michaelshiloh/motorShieldAndBluefruit/images/bluefruit/2.jpg

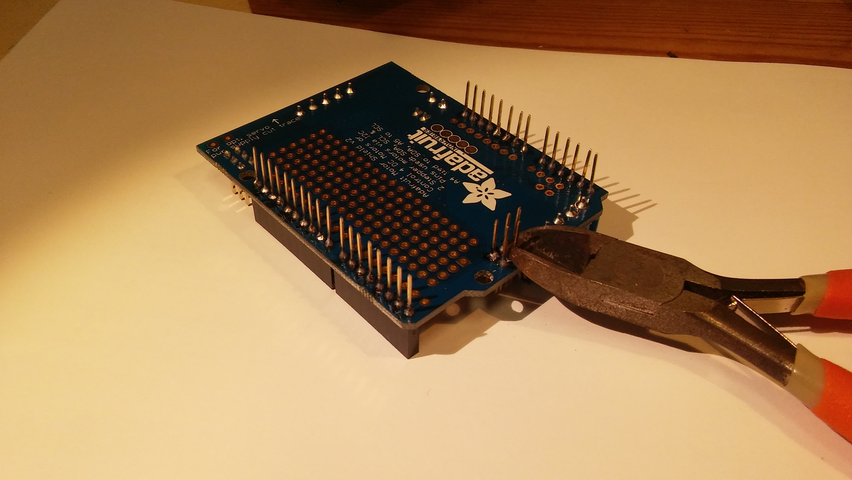
images/bluefruit/2.jpg
