michaelshiloh/motorShieldAndBluefruit/images/bluefruit/3.jpg

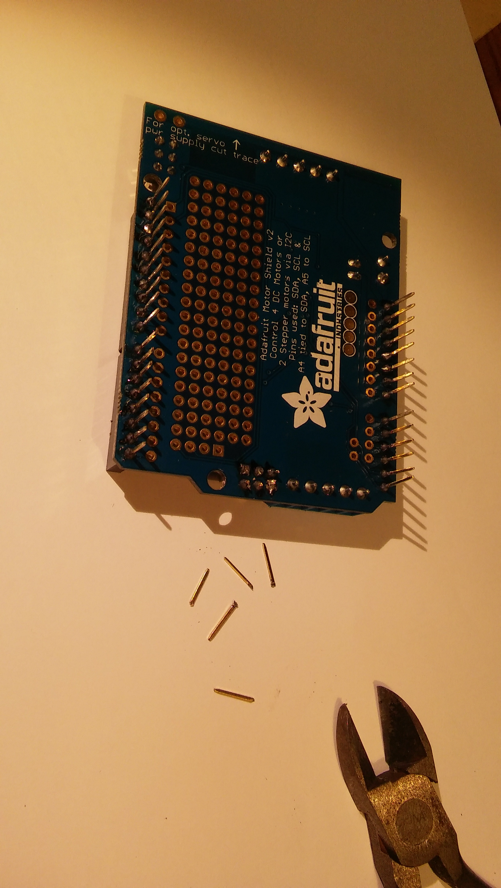
images/bluefruit/3.jpg
