michaelshiloh/motorShieldAndBluefruit/images/bluefruit/4.jpg

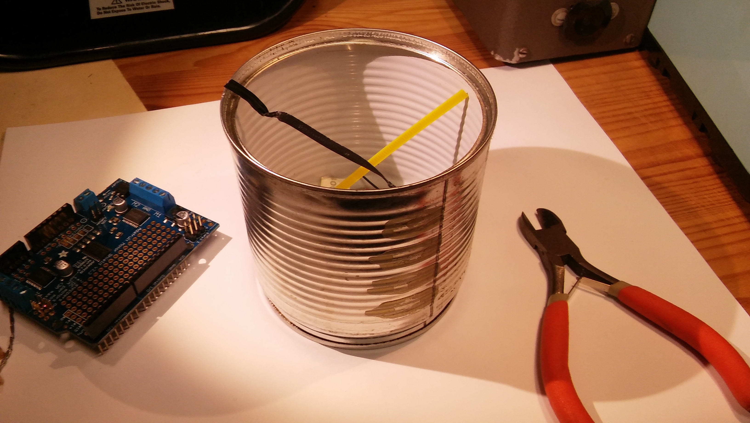
images/bluefruit/4.jpg
