michaelshiloh/motorShieldAndBluefruit/images/bluefruit/5.jpg

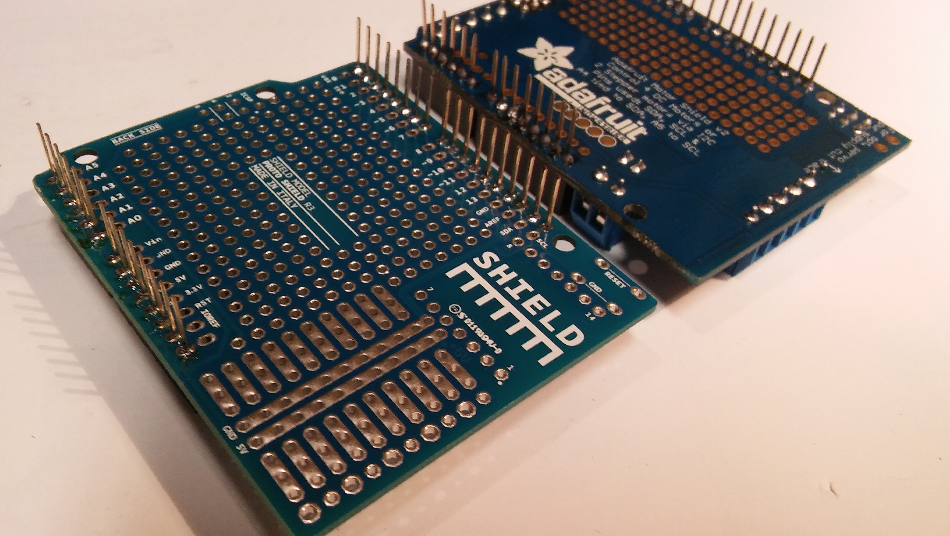
images/bluefruit/5.jpg
