michaelshiloh/motorShieldAndBluefruit/images/bluefruit/6.jpg

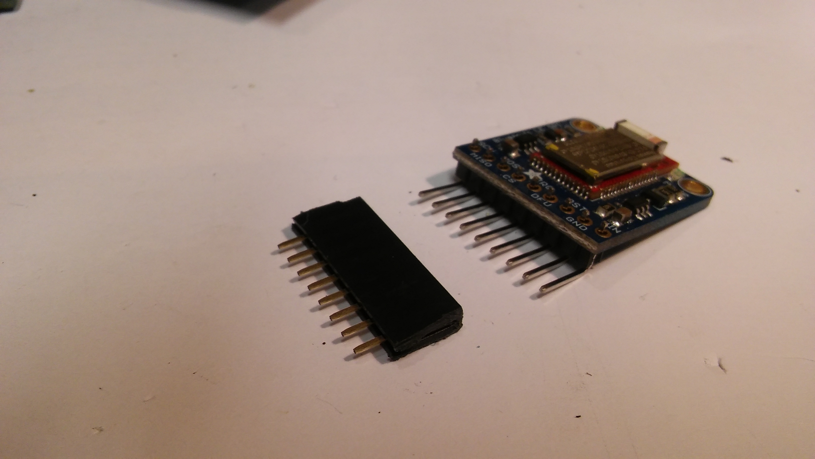
images/bluefruit/6.jpg
