michaelshiloh/motorShieldAndBluefruit/images/bluefruit/7.jpg

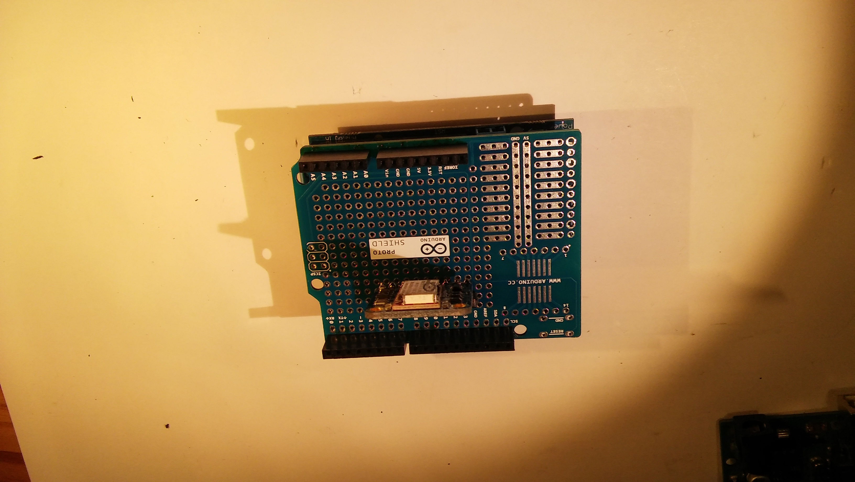
images/bluefruit/7.jpg
