michaelshiloh/motorShieldAndBluefruit/images/bluefruit/8.jpg

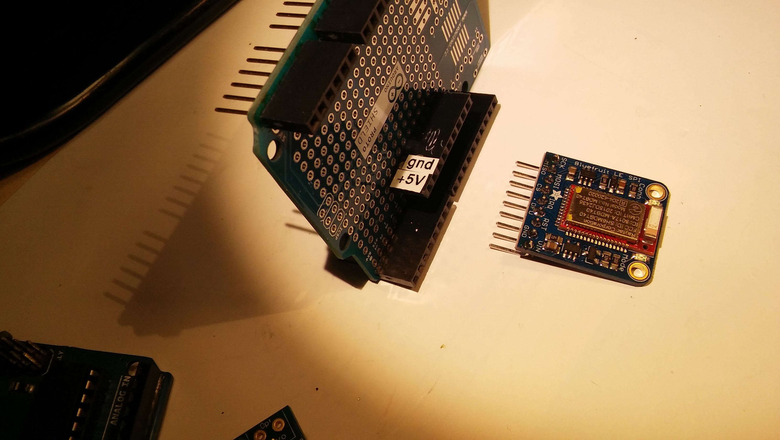
images/bluefruit/8.jpg
