michaelshiloh/motorShieldAndBluefruit/images/bluefruit/9.jpg

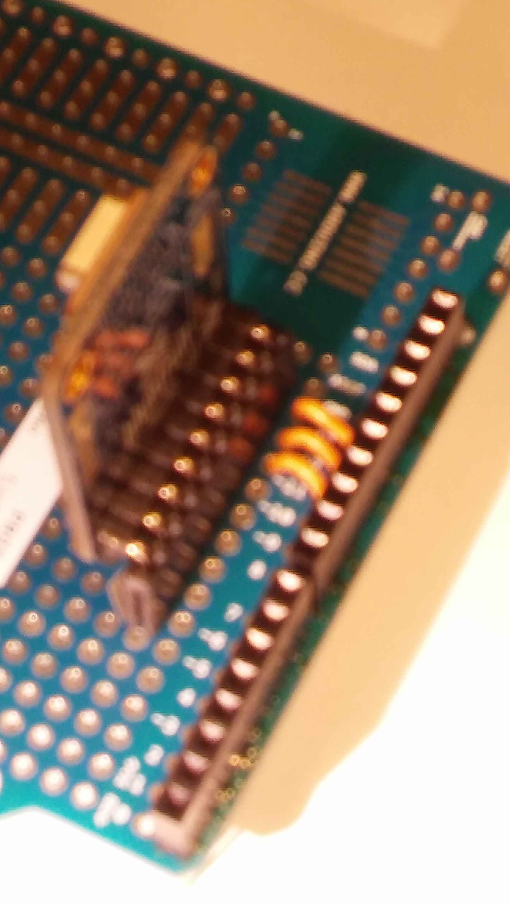
images/bluefruit/9.jpg
