michaelshiloh/motorShieldAndBluefruit/images/bluefruit/10.jpg

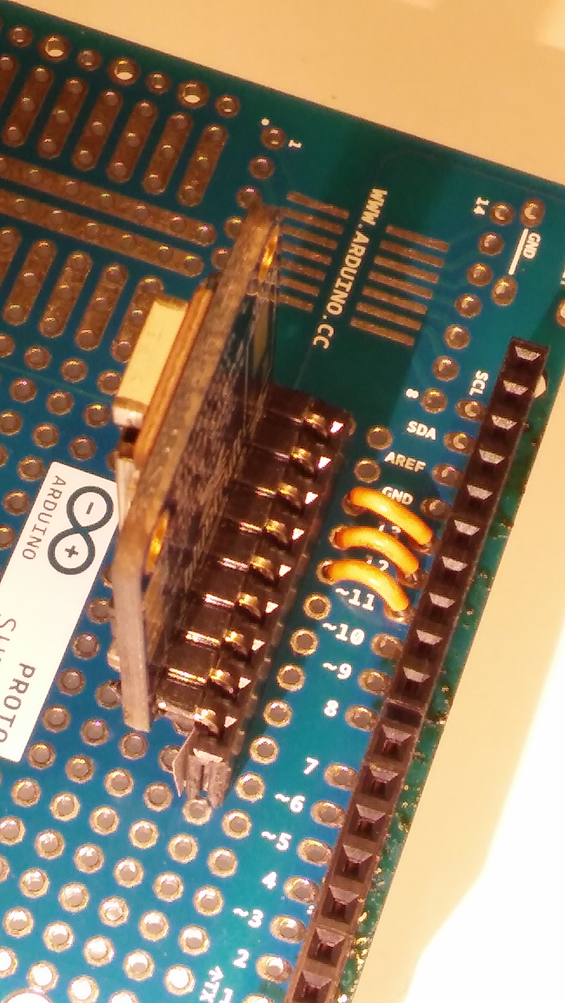
images/bluefruit/10.jpg
