michaelshiloh/motorShieldAndBluefruit/images/bluefruit/11.jpg

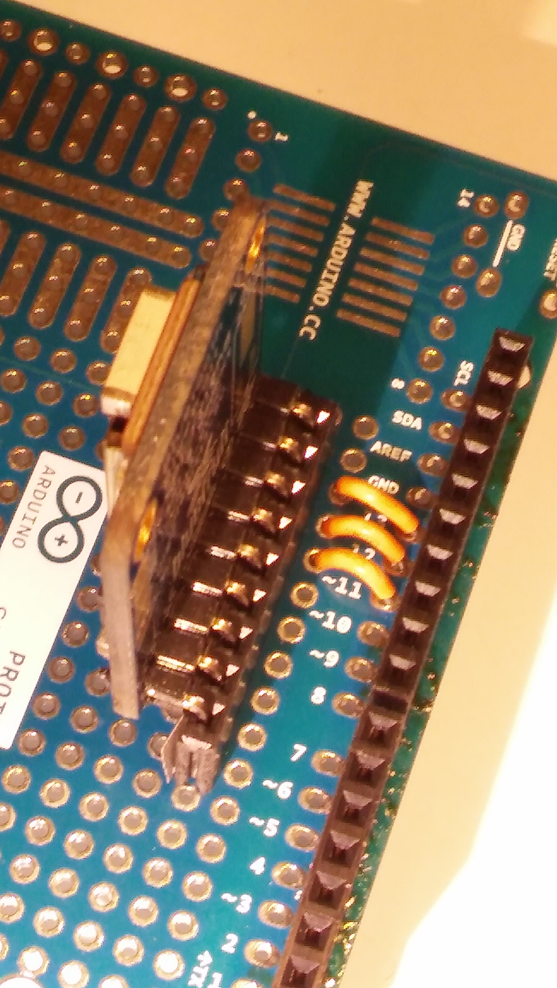
images/bluefruit/11.jpg
