michaelshiloh/motorShieldAndBluefruit/images/bluefruit/12.jpg

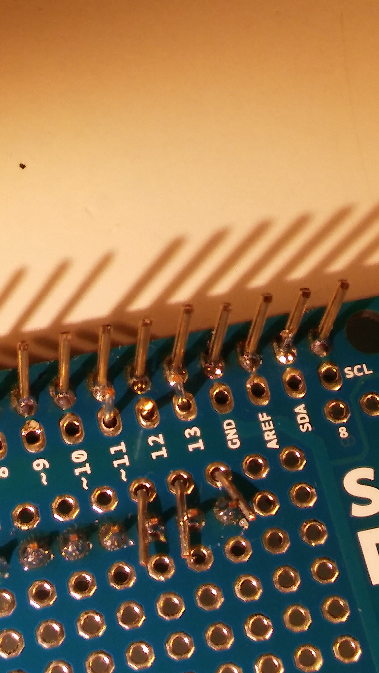
images/bluefruit/12.jpg
