michaelshiloh/motorShieldAndBluefruit/images/bluefruit/13.jpg

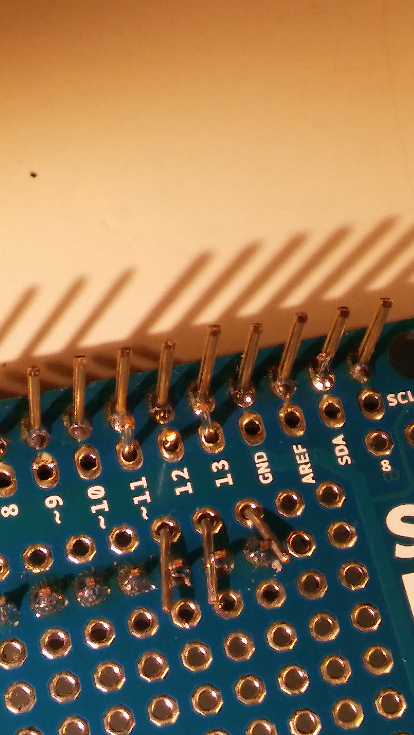
images/bluefruit/13.jpg
