michaelshiloh/motorShieldAndBluefruit/images/bluefruit/14.jpg

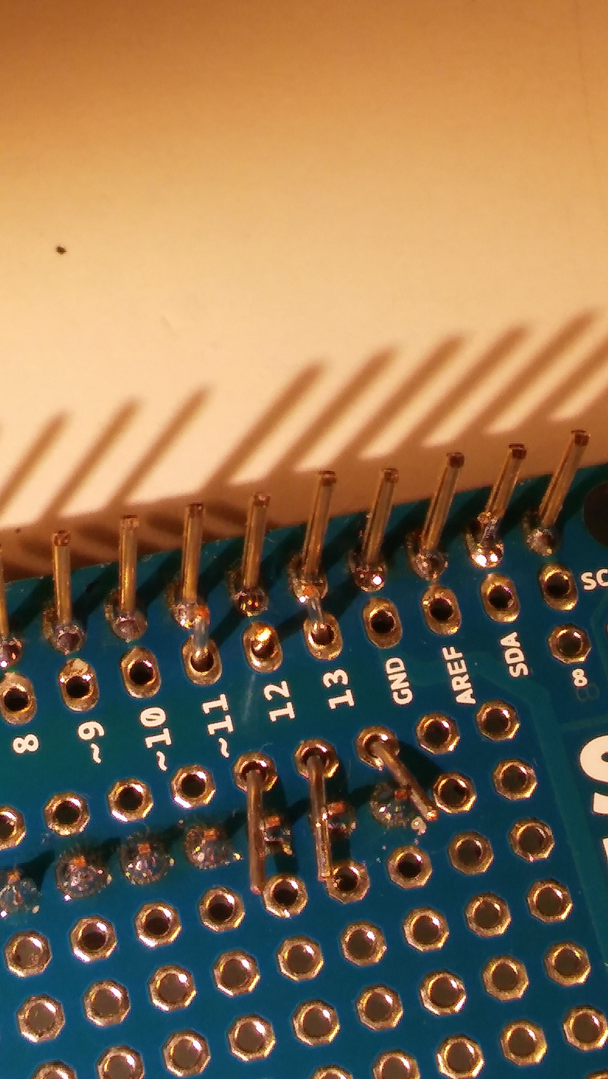
images/bluefruit/14.jpg
