michaelshiloh/motorShieldAndBluefruit/images/bluefruit/15.jpg

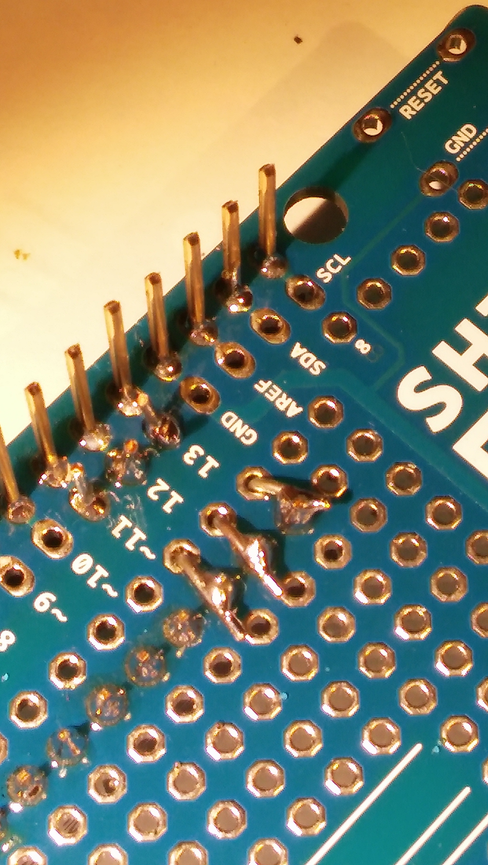
images/bluefruit/15.jpg
