michaelshiloh/motorShieldAndBluefruit/images/bluefruit/16.jpg

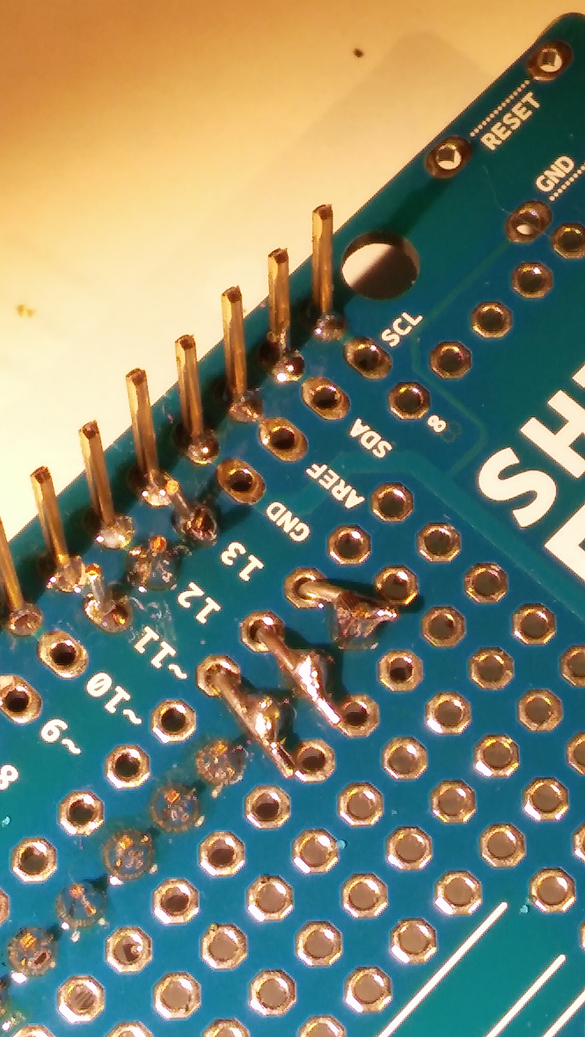
images/bluefruit/16.jpg
