michaelshiloh/motorShieldAndBluefruit/images/bluefruit/18.jpg

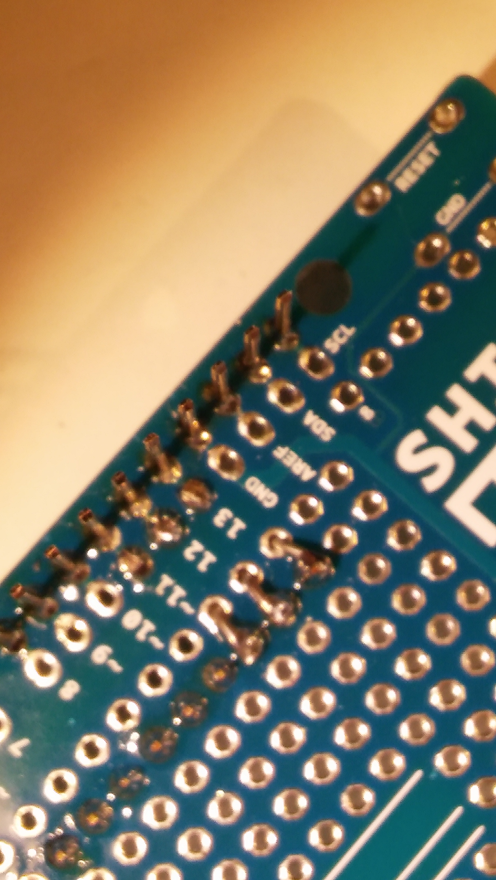
images/bluefruit/18.jpg
