michaelshiloh/motorShieldAndBluefruit/images/bluefruit/19.jpg

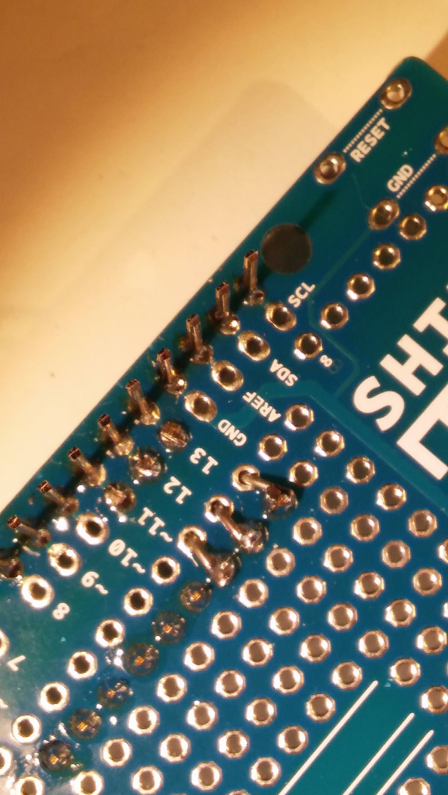
images/bluefruit/19.jpg
