michaelshiloh/motorShieldAndBluefruit/images/bluefruit/24.jpg

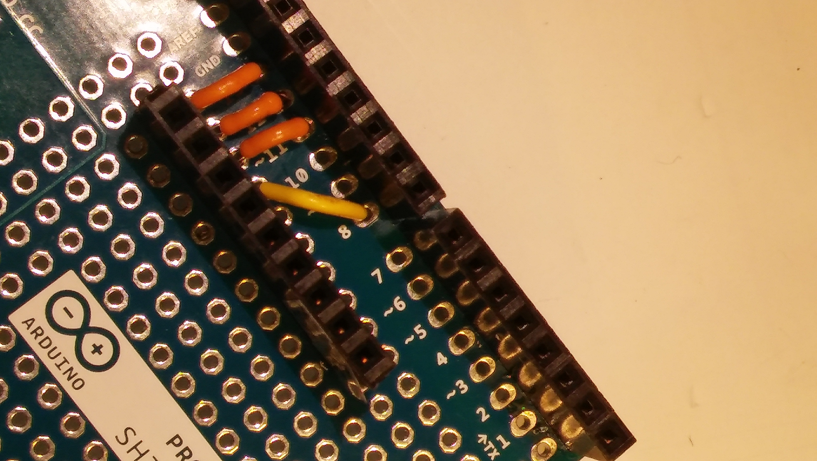
images/bluefruit/24.jpg
