michaelshiloh/motorShieldAndBluefruit/images/bluefruit/25.jpg

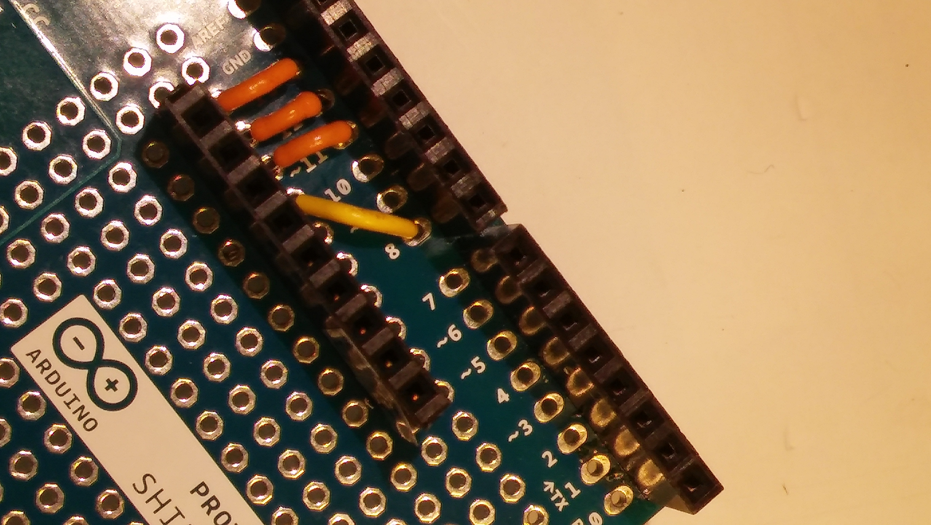
images/bluefruit/25.jpg
