michaelshiloh/motorShieldAndBluefruit/images/bluefruit/27.jpg

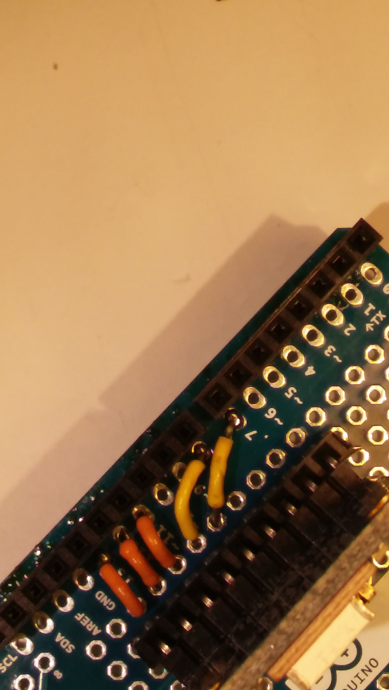
images/bluefruit/27.jpg
