michaelshiloh/motorShieldAndBluefruit/images/bluefruit/29.jpg

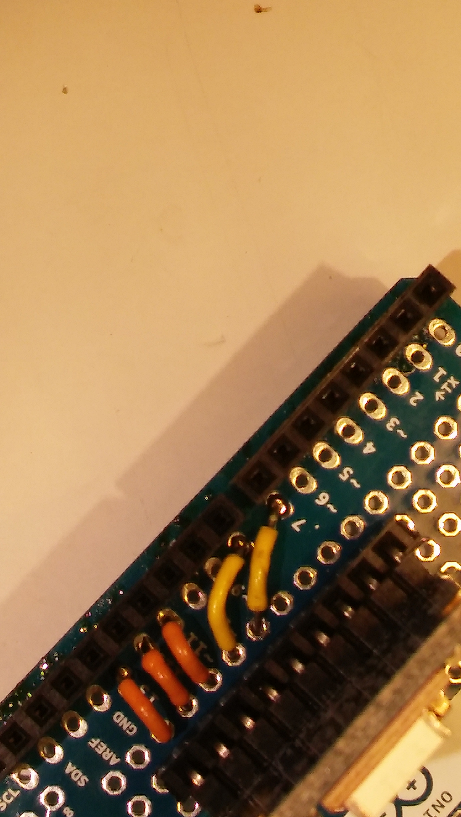
images/bluefruit/29.jpg
