michaelshiloh/motorShieldAndBluefruit/images/bluefruit/30.jpg

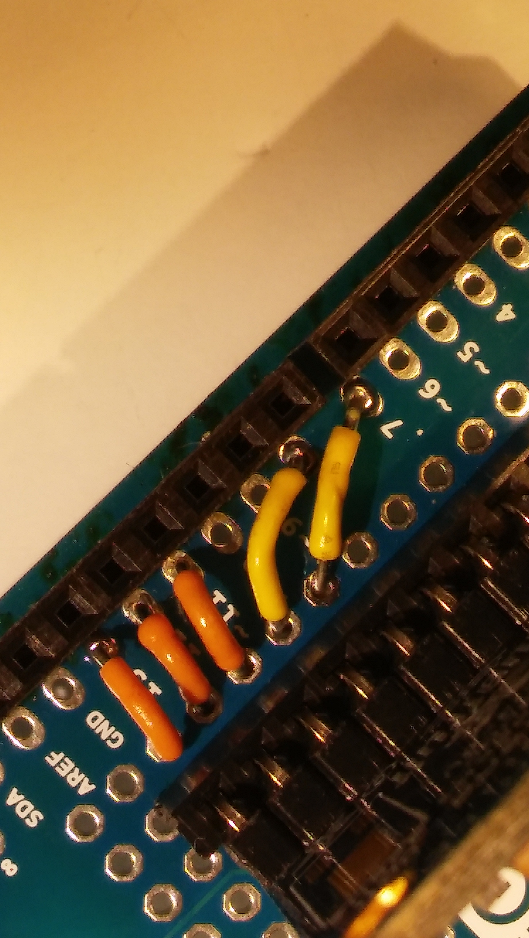
images/bluefruit/30.jpg
