michaelshiloh/motorShieldAndBluefruit/images/bluefruit/31.jpg

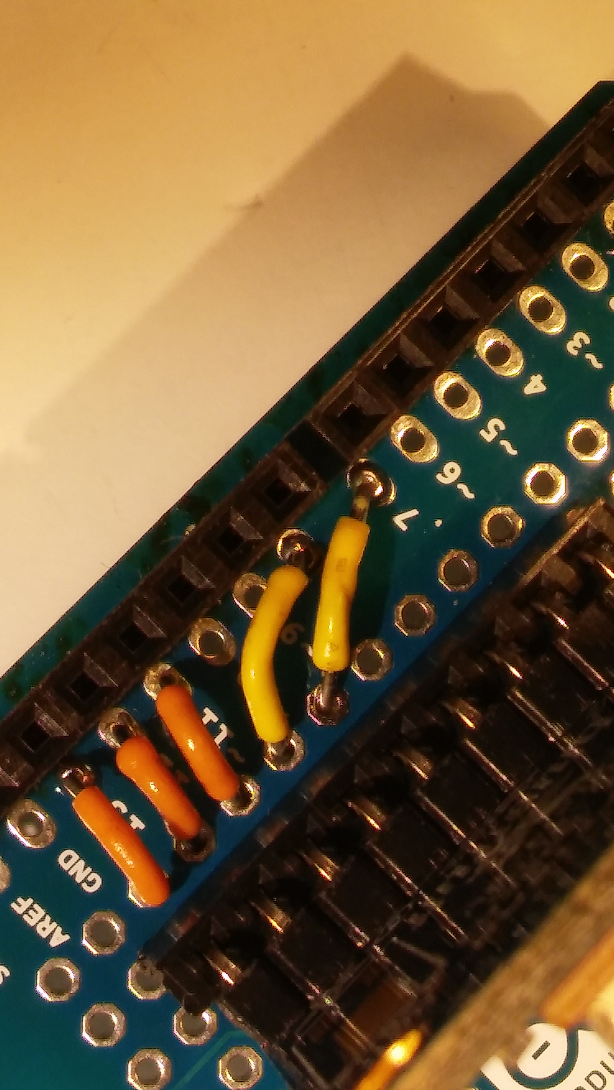
images/bluefruit/31.jpg
