michaelshiloh/motorShieldAndBluefruit/images/bluefruit/32.jpg

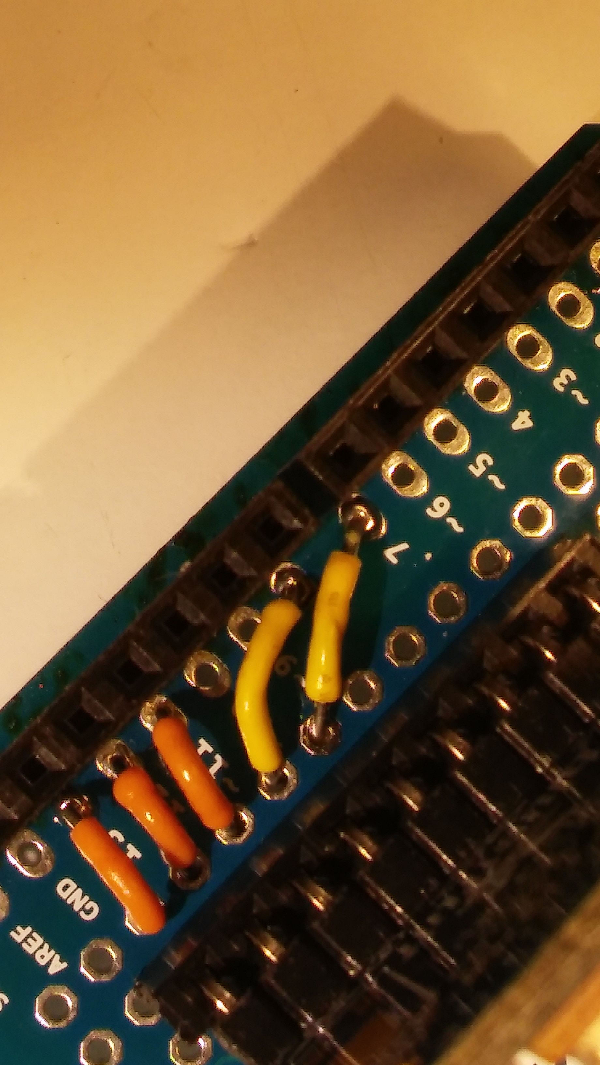
images/bluefruit/32.jpg
