michaelshiloh/motorShieldAndBluefruit/images/bluefruit/33.jpg

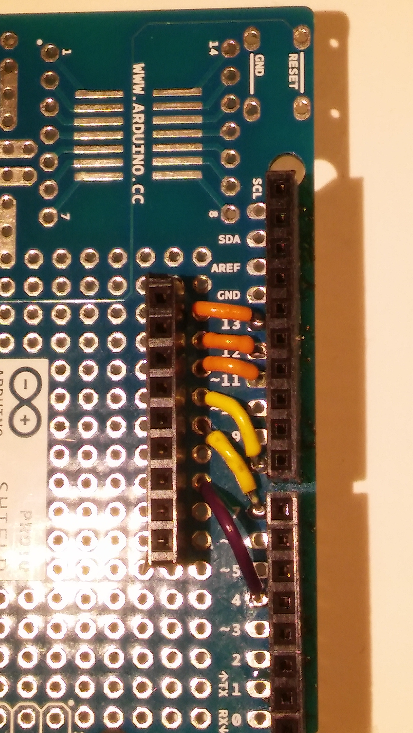
images/bluefruit/33.jpg
