michaelshiloh/motorShieldAndBluefruit/images/bluefruit/34.jpg

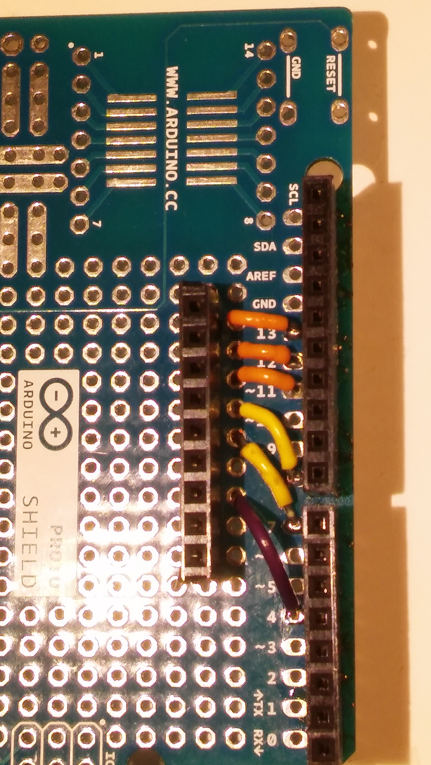
images/bluefruit/34.jpg
