michaelshiloh/motorShieldAndBluefruit/images/bluefruit/35.jpg

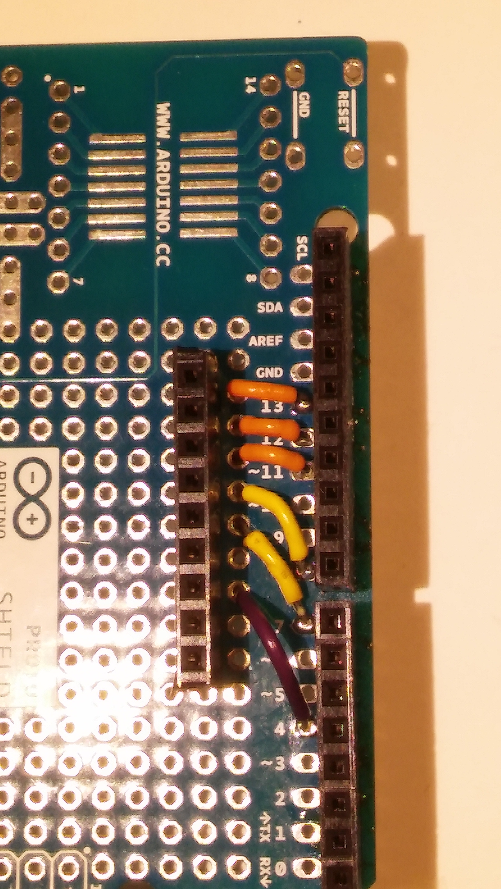
images/bluefruit/35.jpg
