michaelshiloh/motorShieldAndBluefruit/images/bluefruit/36.jpg

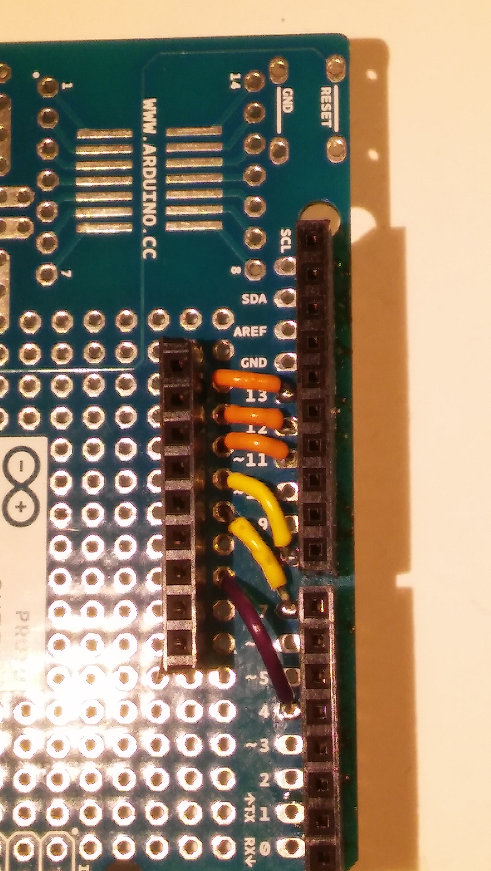
images/bluefruit/36.jpg
