michaelshiloh/motorShieldAndBluefruit/images/bluefruit/37.jpg

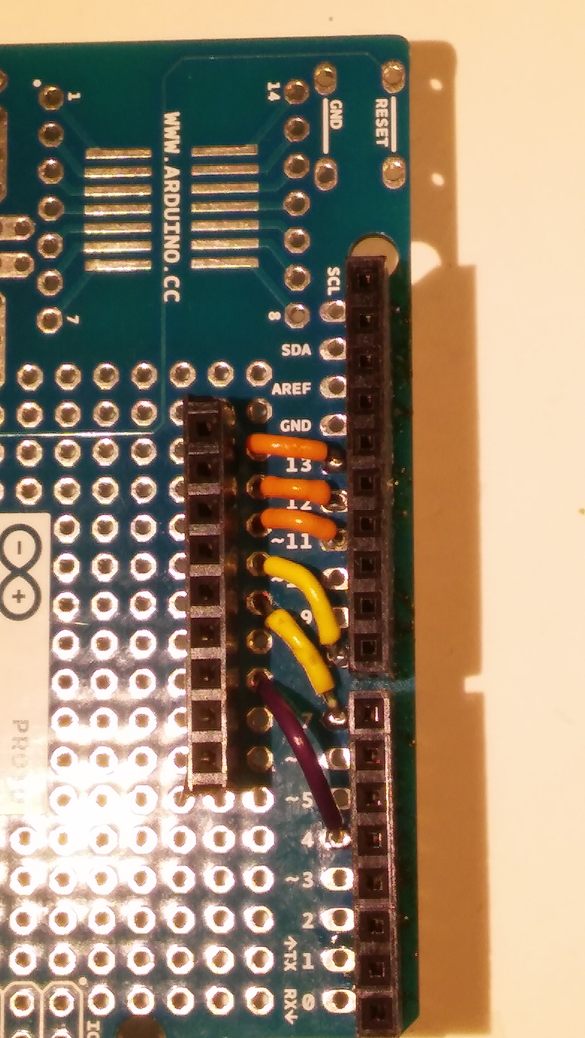
images/bluefruit/37.jpg
