michaelshiloh/motorShieldAndBluefruit/images/bluefruit/39.jpg

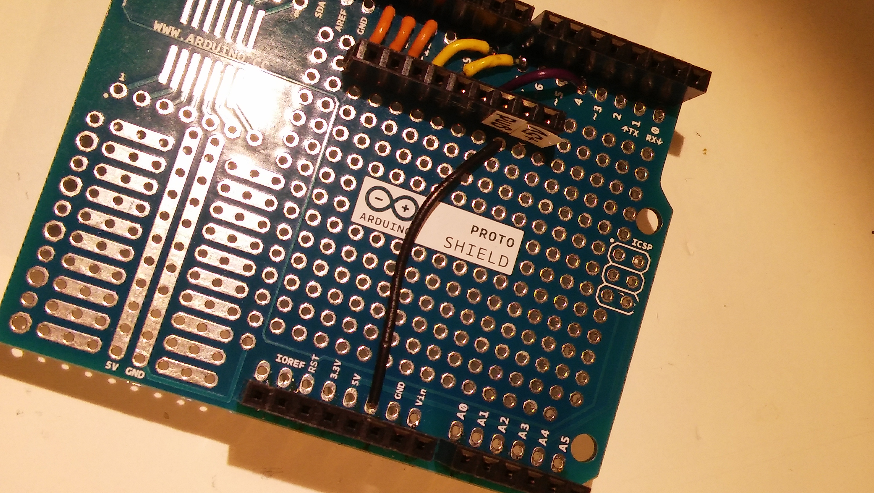
images/bluefruit/39.jpg
