michaelshiloh/motorShieldAndBluefruit/images/bluefruit/41.jpg

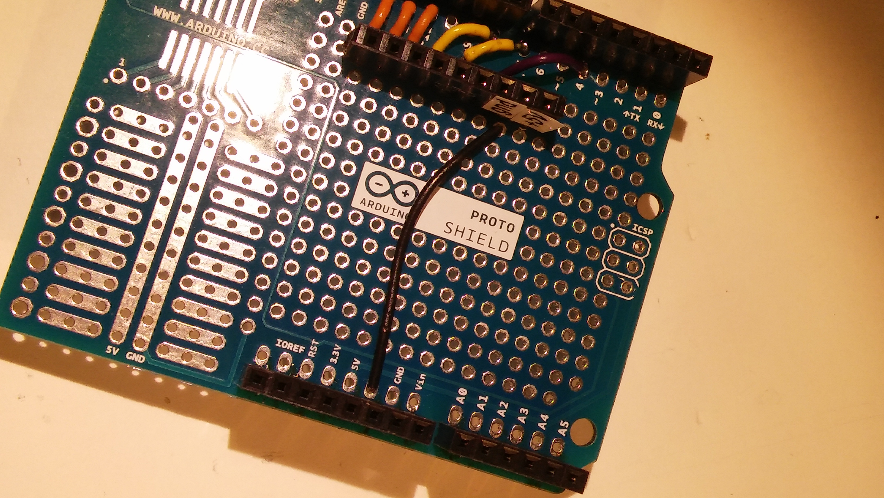
images/bluefruit/41.jpg
