michaelshiloh/motorShieldAndBluefruit/images/bluefruit/42.jpg

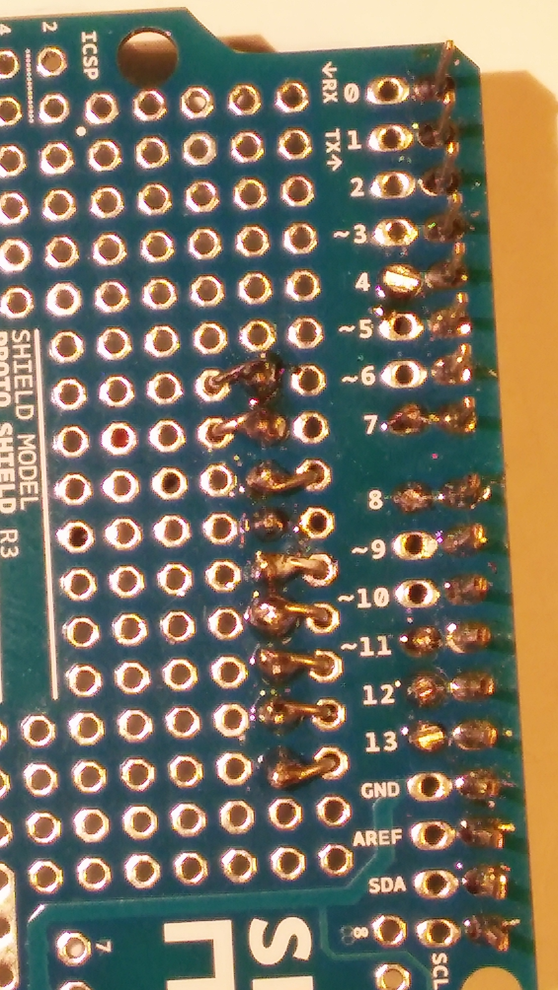
images/bluefruit/42.jpg
