michaelshiloh/motorShieldAndBluefruit/images/bluefruit/43.jpg

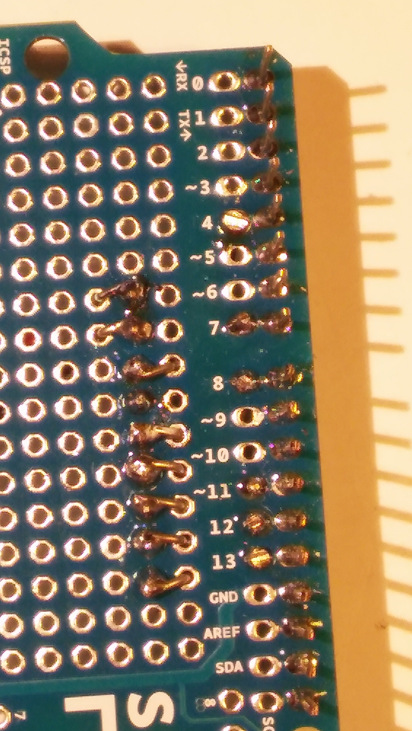
images/bluefruit/43.jpg
