michaelshiloh/motorShieldAndBluefruit/images/bluefruit/44.jpg

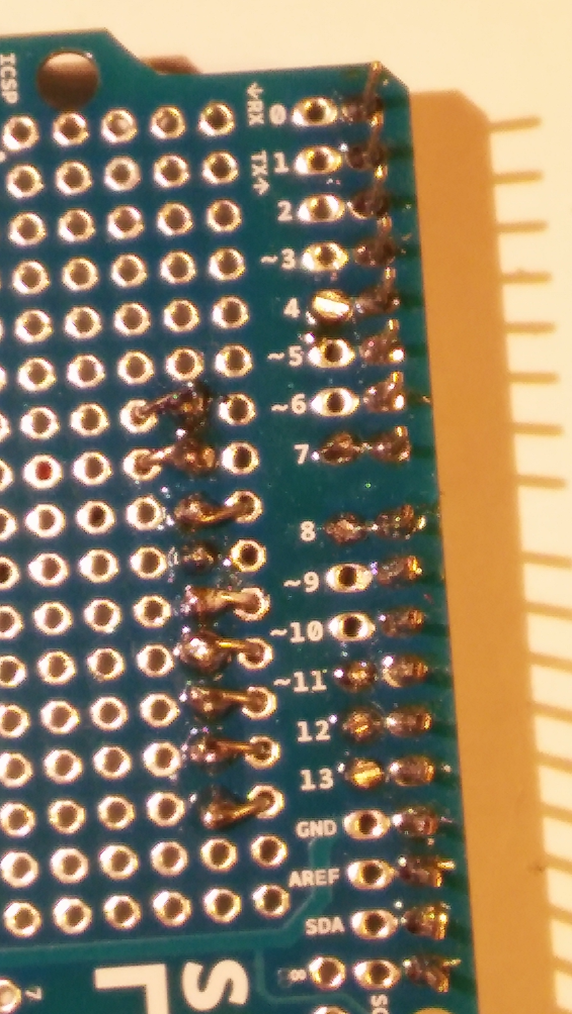
images/bluefruit/44.jpg
