michaelshiloh/motorShieldAndBluefruit/images/bluefruit/45.jpg

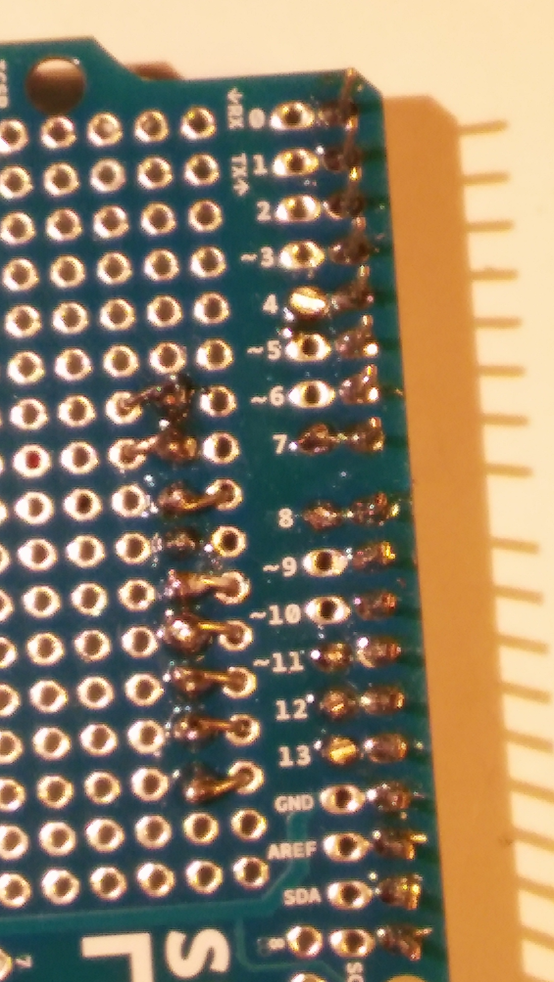
images/bluefruit/45.jpg
