michaelshiloh/motorShieldAndBluefruit/images/bluefruit/46.jpg

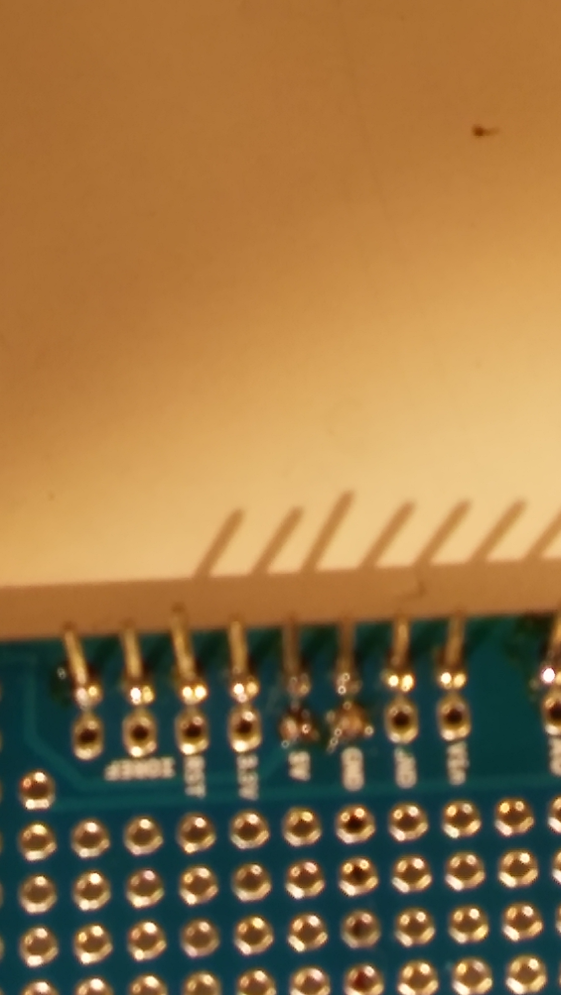
images/bluefruit/46.jpg
