michaelshiloh/motorShieldAndBluefruit/images/bluefruit/47.jpg

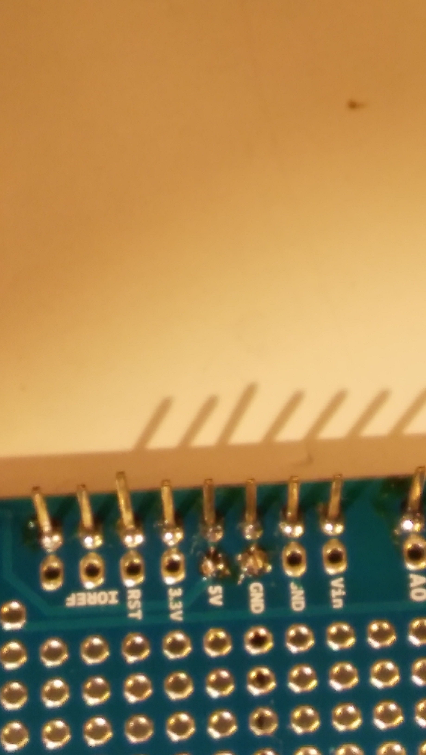
images/bluefruit/47.jpg
