michaelshiloh/motorShieldAndBluefruit/images/bluefruit/48.jpg

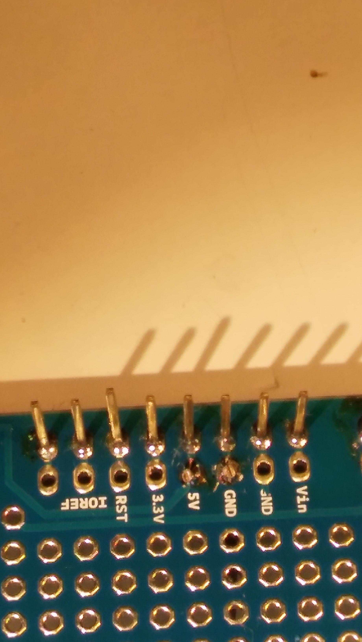
images/bluefruit/48.jpg
