michaelshiloh/motorShieldAndBluefruit/images/bluefruit/49.jpg

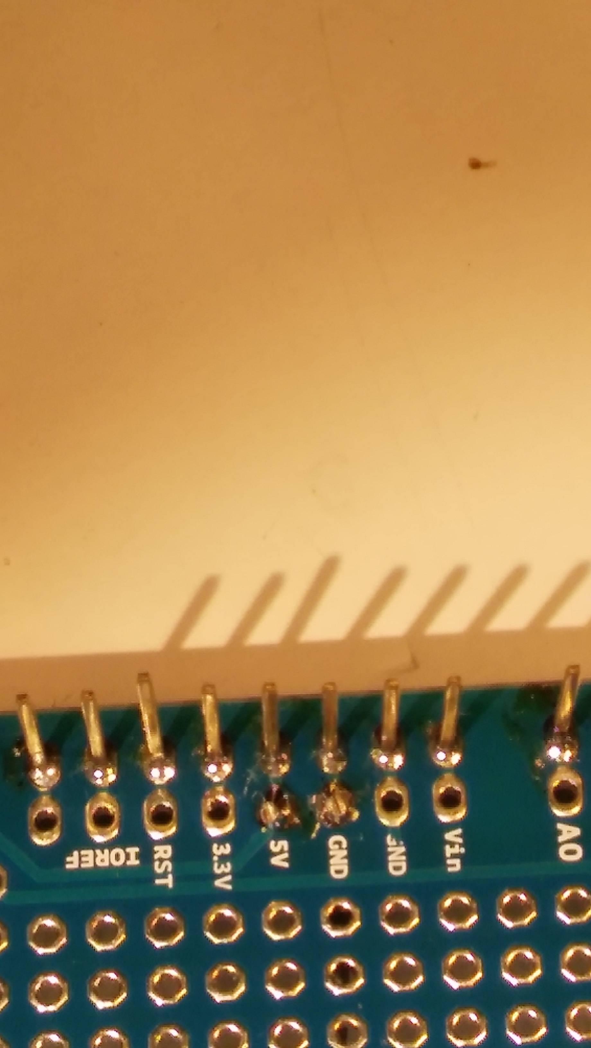
images/bluefruit/49.jpg
