michaelshiloh/motorShieldAndBluefruit/images/bluefruit/50.jpg

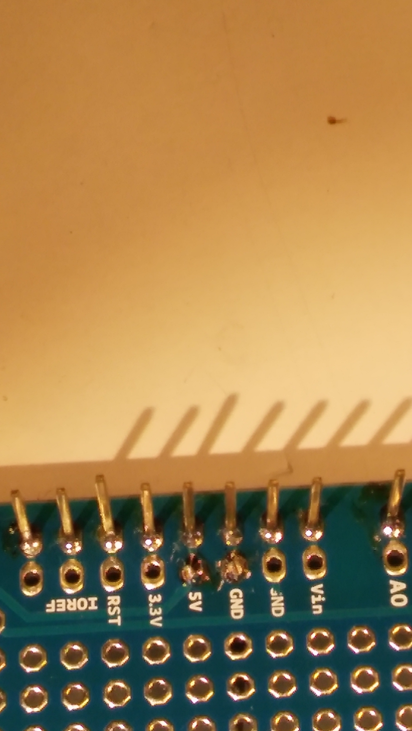
images/bluefruit/50.jpg
