michaelshiloh/motorShieldAndBluefruit/images/bluefruit/60.jpg

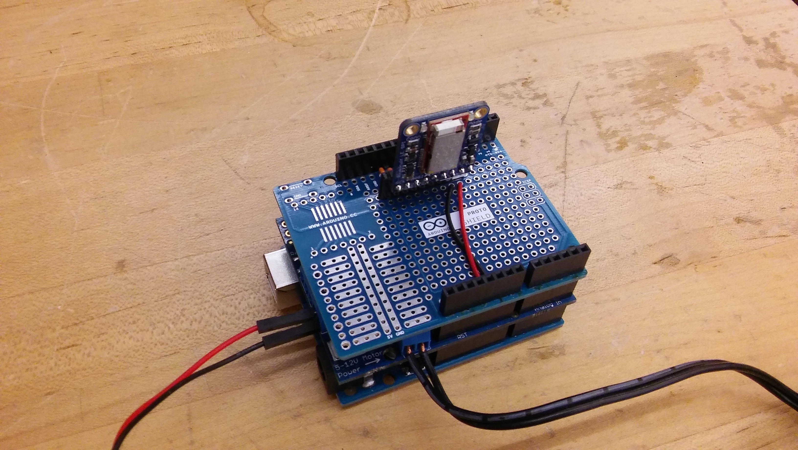
images/bluefruit/60.jpg
