michaelshiloh/motorShieldAndBluefruit/images/bluefruit/61.jpg

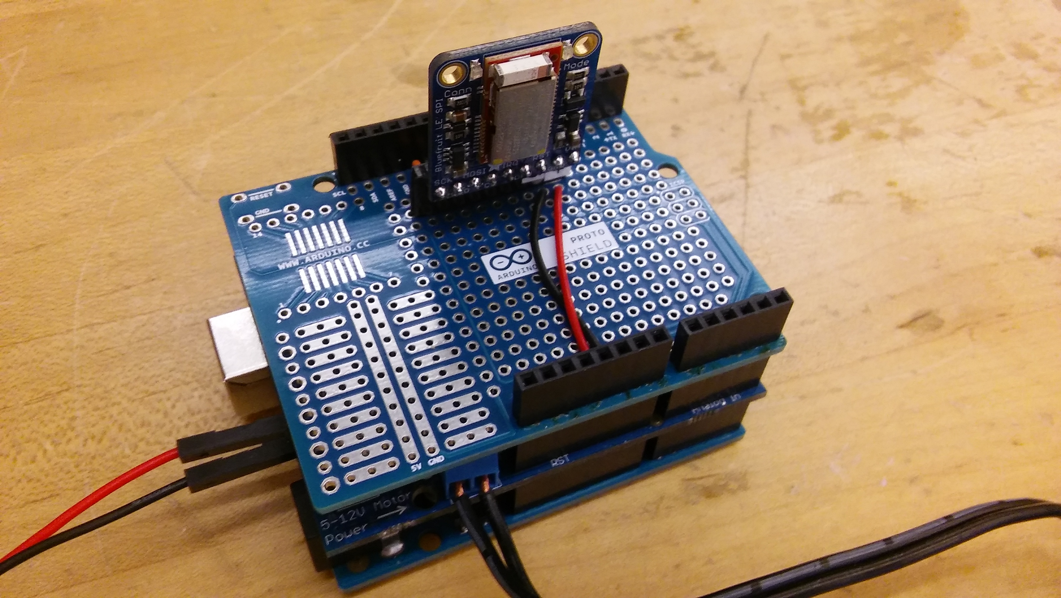
images/bluefruit/61.jpg
