michaelshiloh/motorShieldAndBluefruit/images/bluefruit/62.jpg

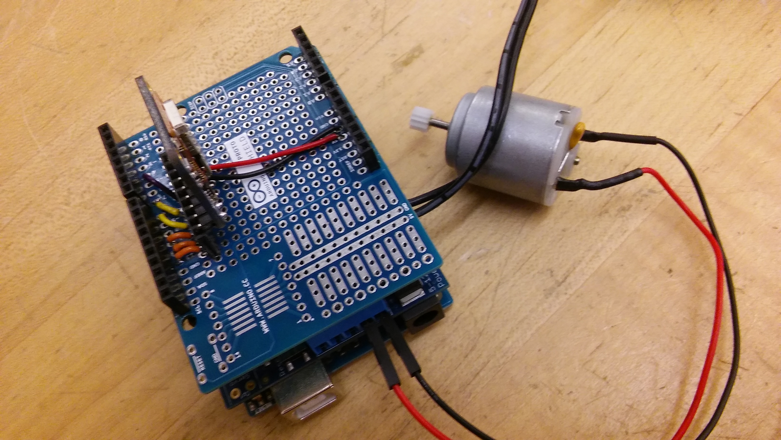
images/bluefruit/62.jpg
