michaelshiloh/motorShieldAndBluefruit/images/bluefruit/63.jpg

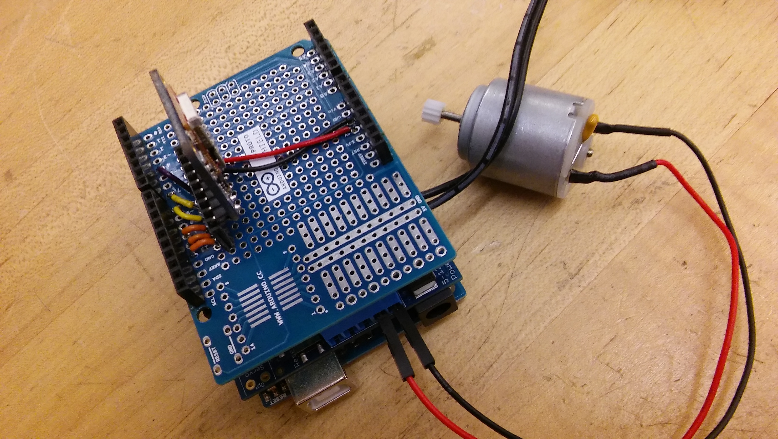
images/bluefruit/63.jpg
