michaelshiloh/motorShieldAndBluefruit/images/bluefruit/64.jpg

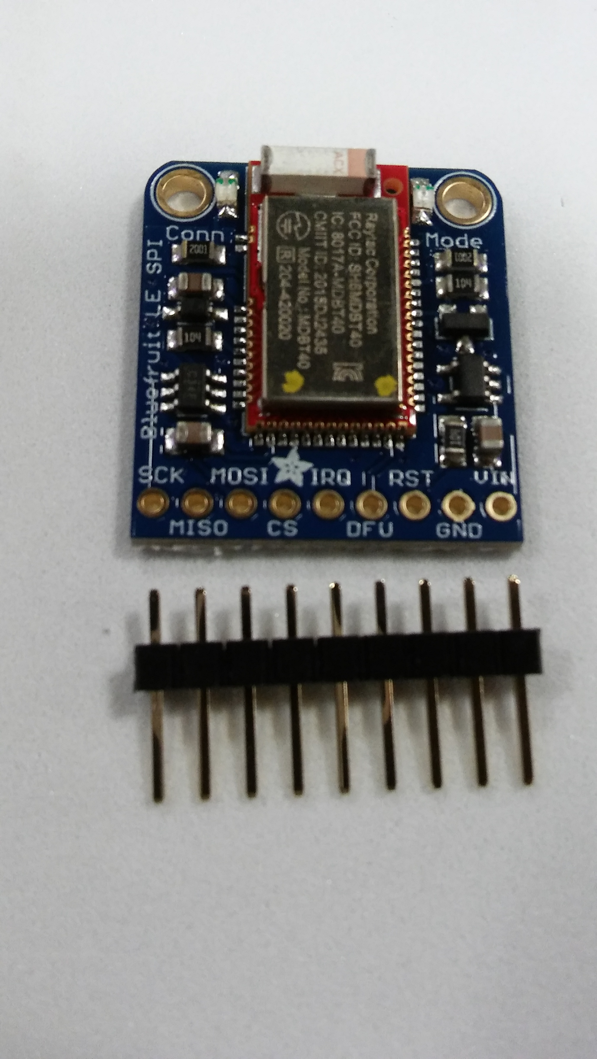
images/bluefruit/64.jpg
