michaelshiloh/motorShieldAndBluefruit/images/bluefruit/65.jpg

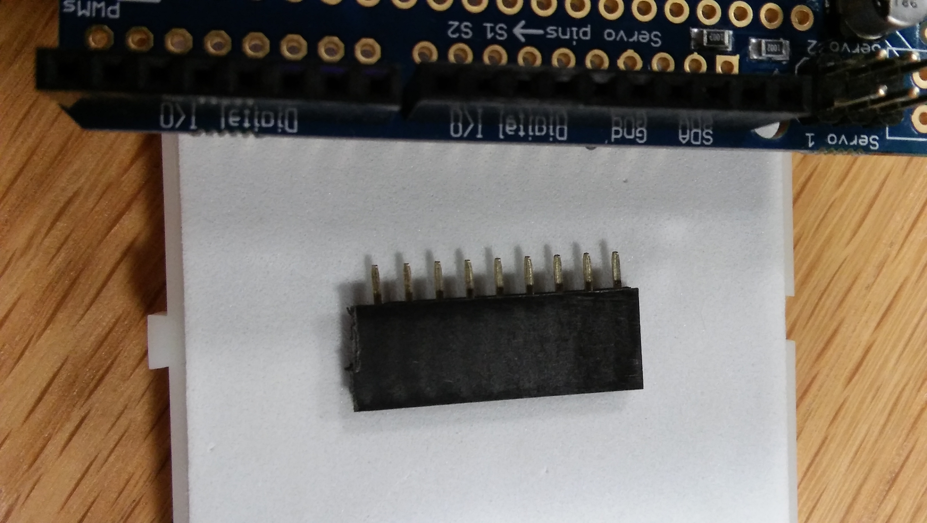
images/bluefruit/65.jpg
