michaelshiloh/motorShieldAndBluefruit/images/bluefruit/67.jpg

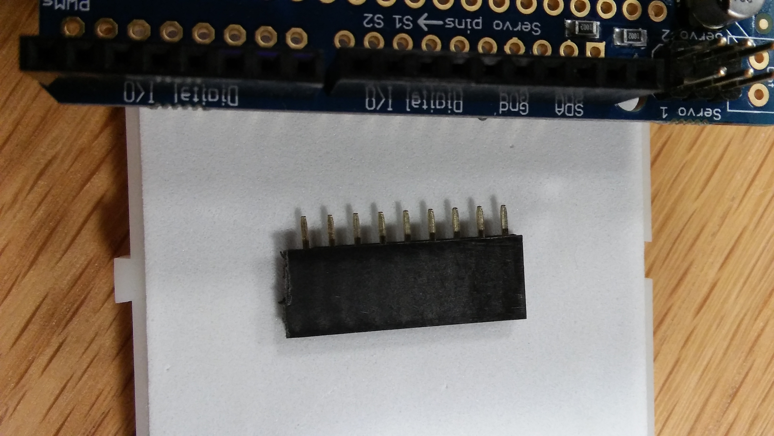
images/bluefruit/67.jpg
