michaelshiloh/motorShieldAndBluefruit/images/bluefruit/68.jpg

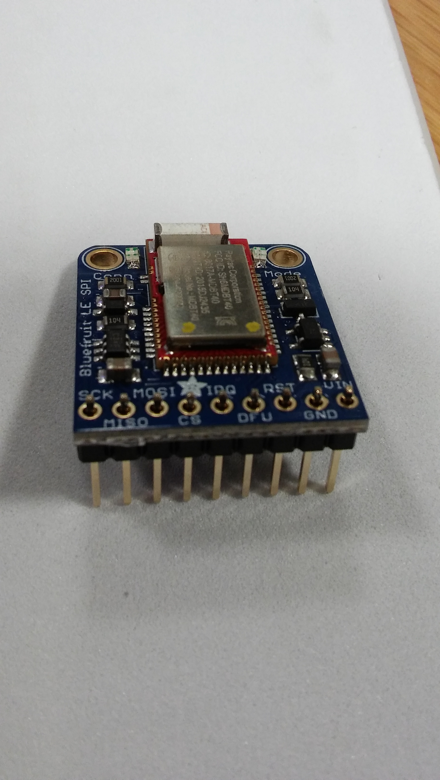
images/bluefruit/68.jpg
