michaelshiloh/motorShieldAndBluefruit/images/bluefruit/69.jpg

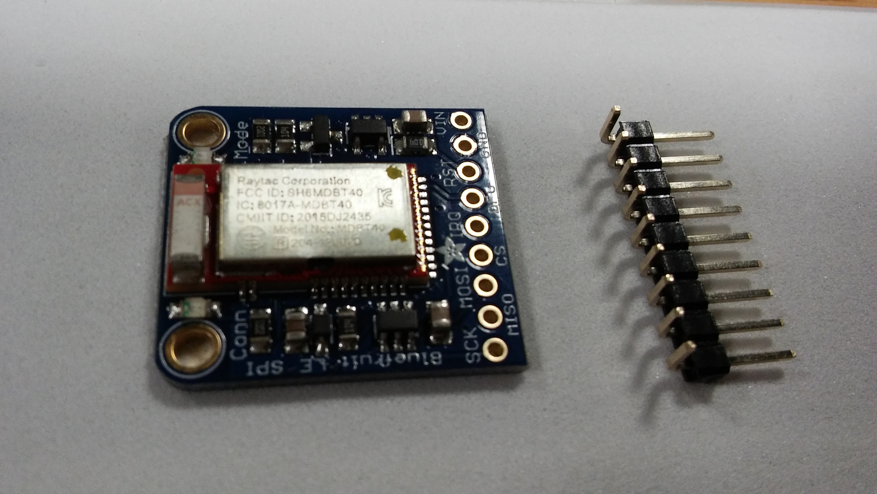
images/bluefruit/69.jpg
