michaelshiloh/motorShieldAndBluefruit/images/bluefruit/70.jpg

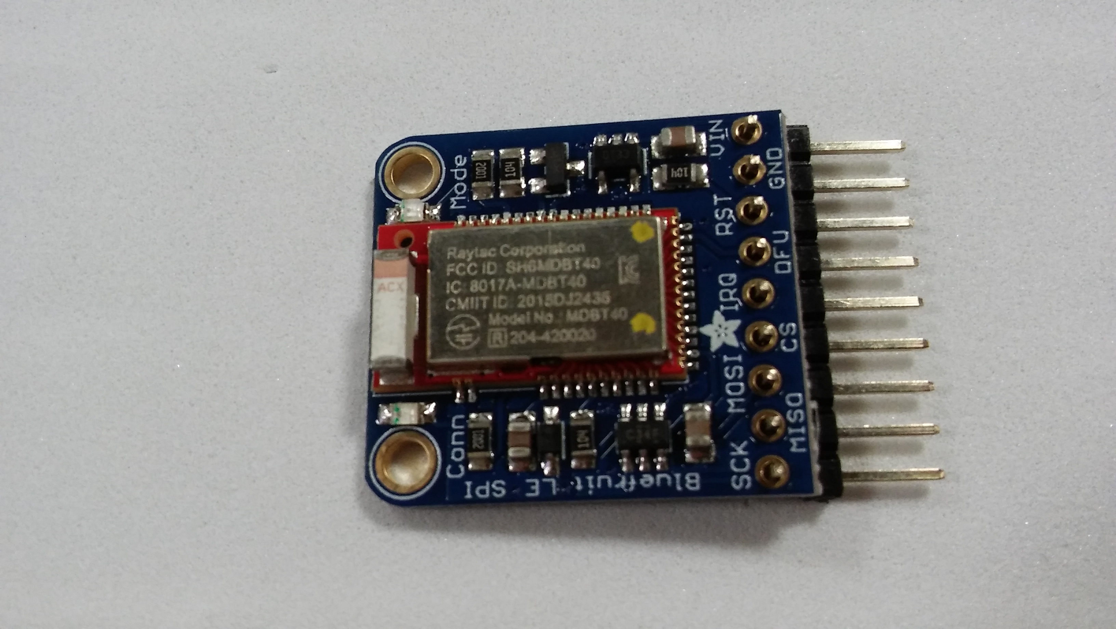
images/bluefruit/70.jpg
