michaelshiloh/motorShieldAndBluefruit/images/bluefruit/71.jpg

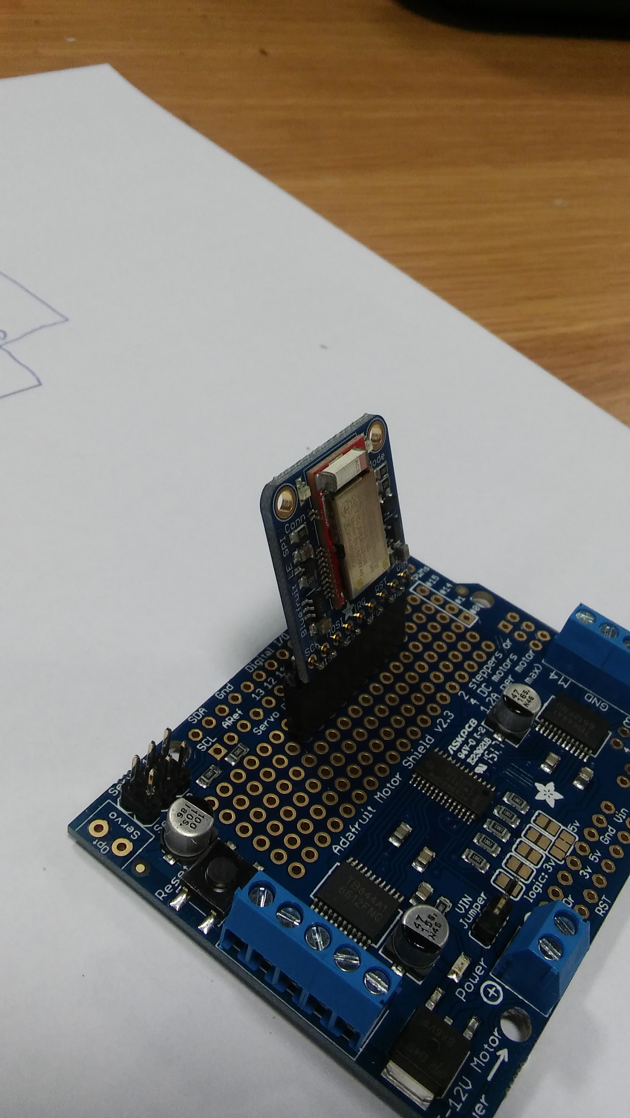
images/bluefruit/71.jpg
