michaelshiloh/motorShieldAndBluefruit/images/bluefruit/76.jpg

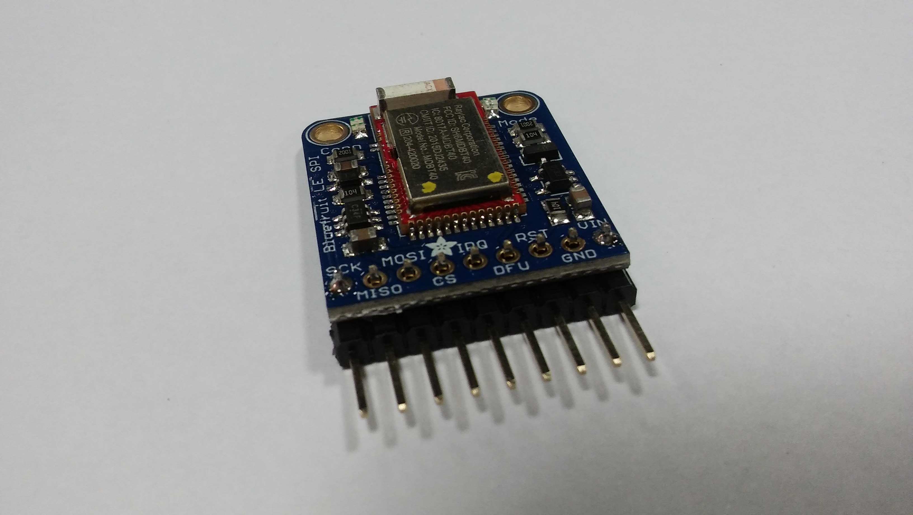
images/bluefruit/76.jpg
