michaelshiloh/motorShieldAndBluefruit/images/bluefruit/78.jpg

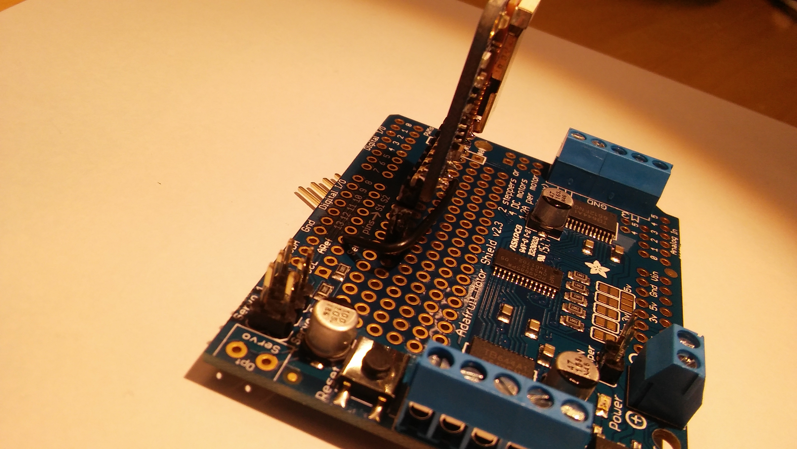
images/bluefruit/78.jpg
