michaelshiloh/motorShieldAndBluefruit/images/bluefruit/79.jpg

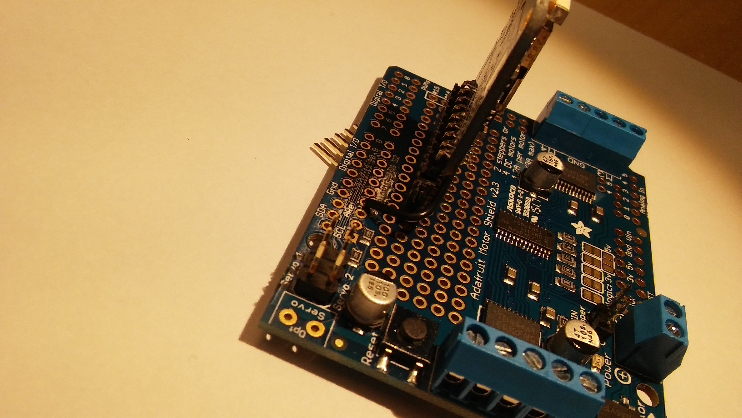
images/bluefruit/79.jpg
