michaelshiloh/motorShieldAndBluefruit/images/bluefruit/80.jpg

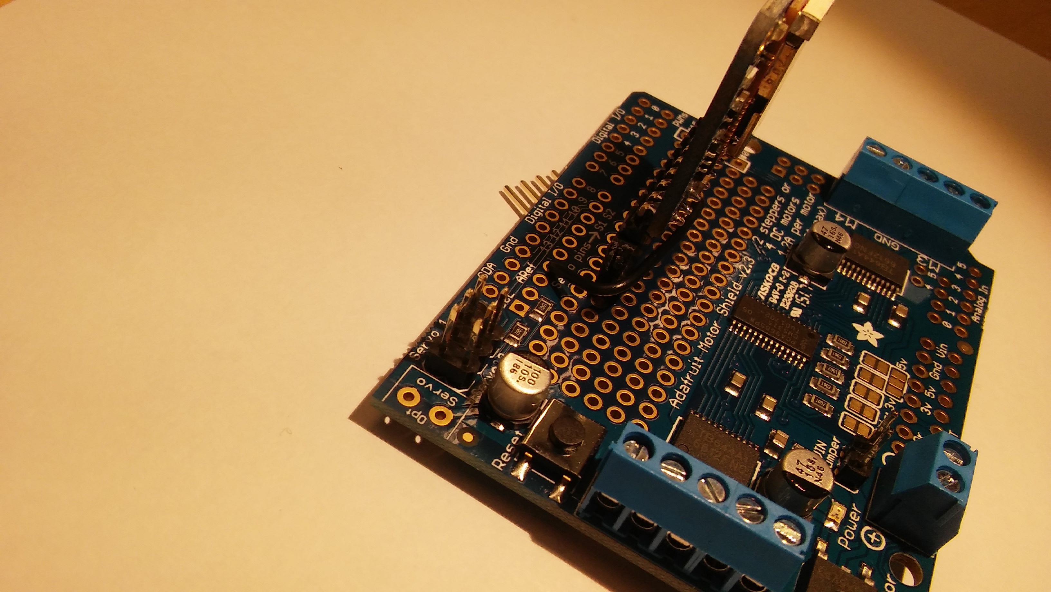
images/bluefruit/80.jpg
