michaelshiloh/motorShieldAndBluefruit/images/bluefruit/81.jpg

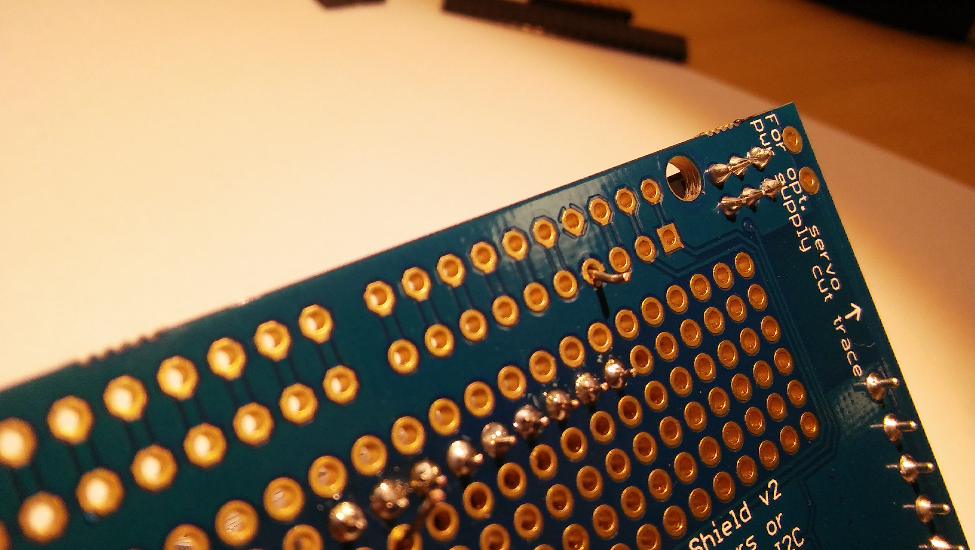
images/bluefruit/81.jpg
