michaelshiloh/motorShieldAndBluefruit/images/bluefruit/82.jpg

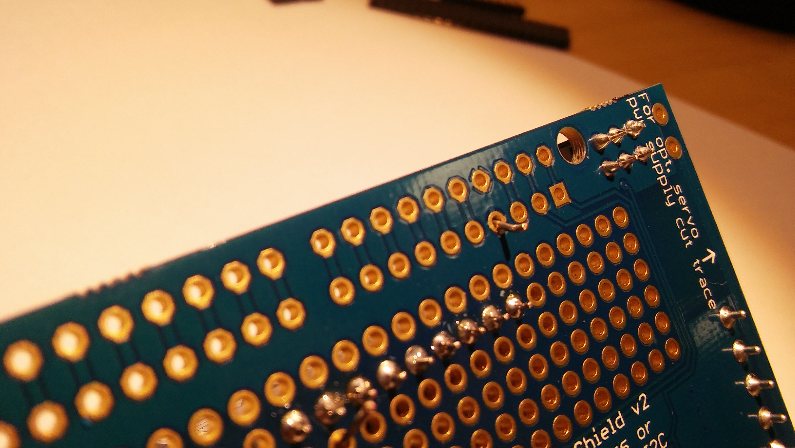
images/bluefruit/82.jpg
