michaelshiloh/motorShieldAndBluefruit/images/bluefruit/83.jpg

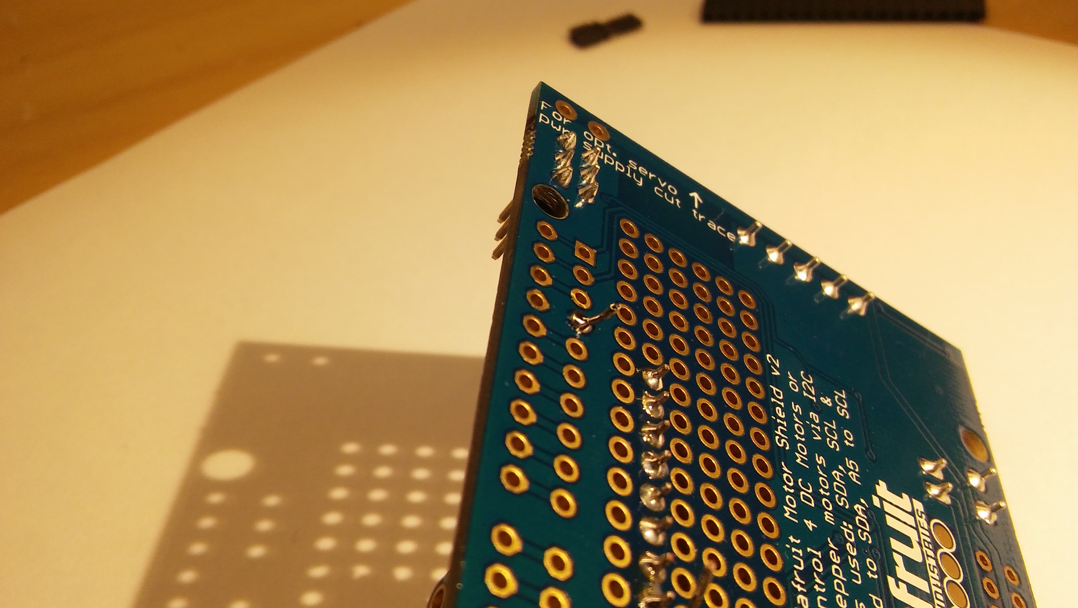
images/bluefruit/83.jpg
