michaelshiloh/motorShieldAndBluefruit/images/bluefruit/84.jpg

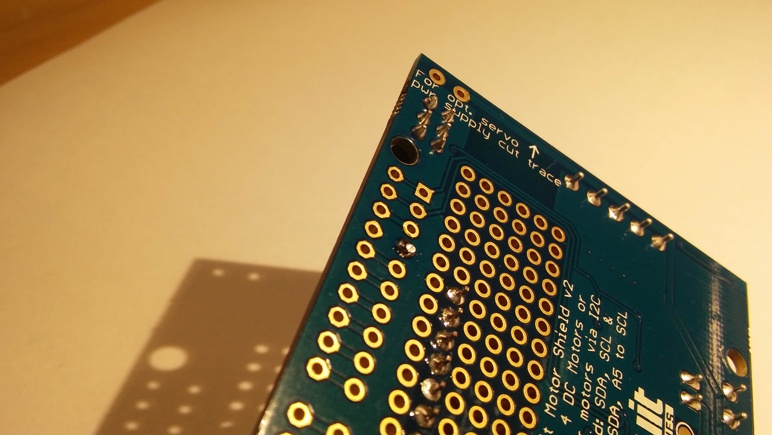
images/bluefruit/84.jpg
