michaelshiloh/motorShieldAndBluefruit/images/bluefruit/85.jpg

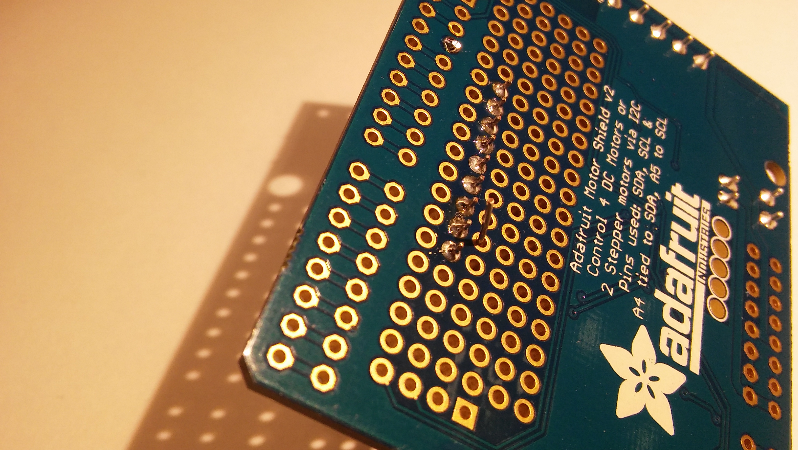
images/bluefruit/85.jpg
