michaelshiloh/motorShieldAndBluefruit/images/bluefruit/88.jpg

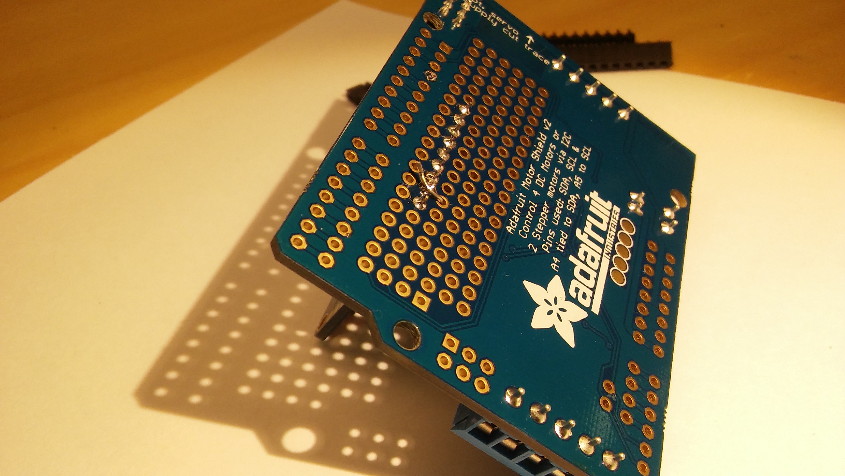
images/bluefruit/88.jpg
