michaelshiloh/motorShieldAndBluefruit/images/bluefruit/91.jpg

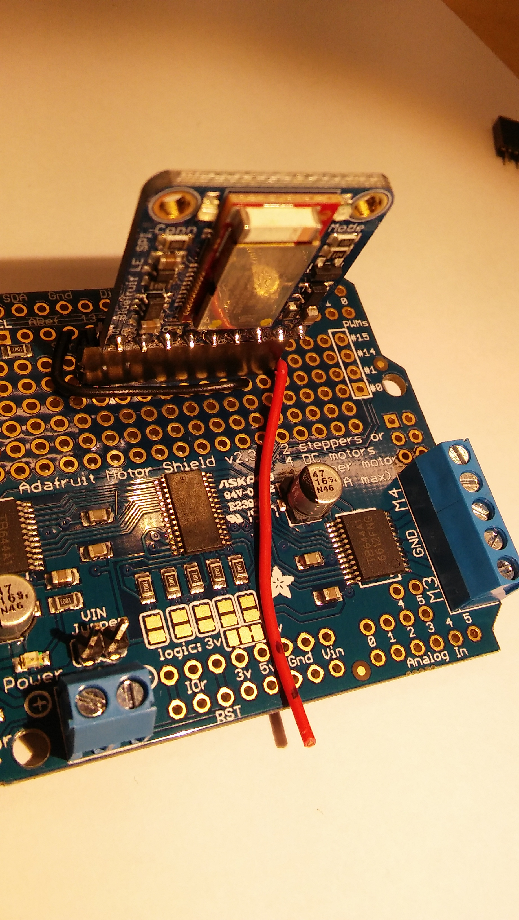
images/bluefruit/91.jpg
