michaelshiloh/motorShieldAndBluefruit/images/bluefruit/92.jpg

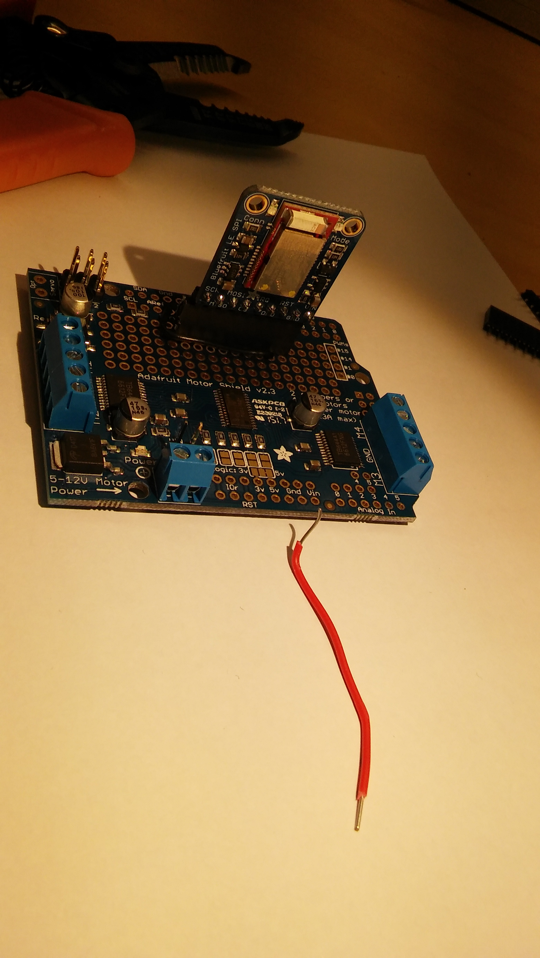
images/bluefruit/92.jpg
