michaelshiloh/motorShieldAndBluefruit/images/bluefruit/97.jpg

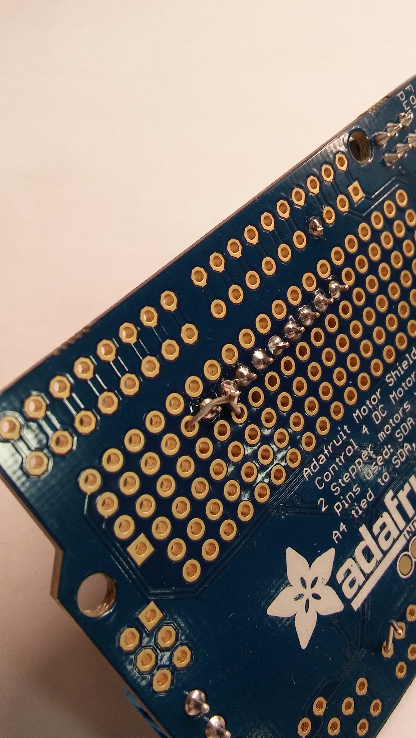
images/bluefruit/97.jpg
