michaelshiloh/motorShieldAndBluefruit/images/bluefruit/98.jpg

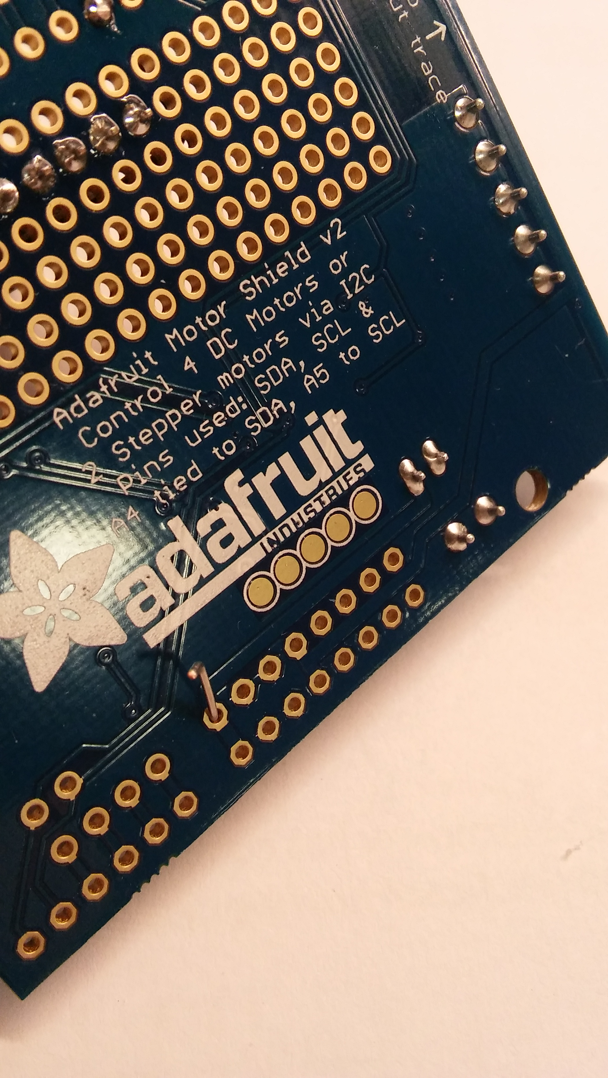
images/bluefruit/98.jpg
