michaelshiloh/motorShieldAndBluefruit/images/bluefruit/99.jpg

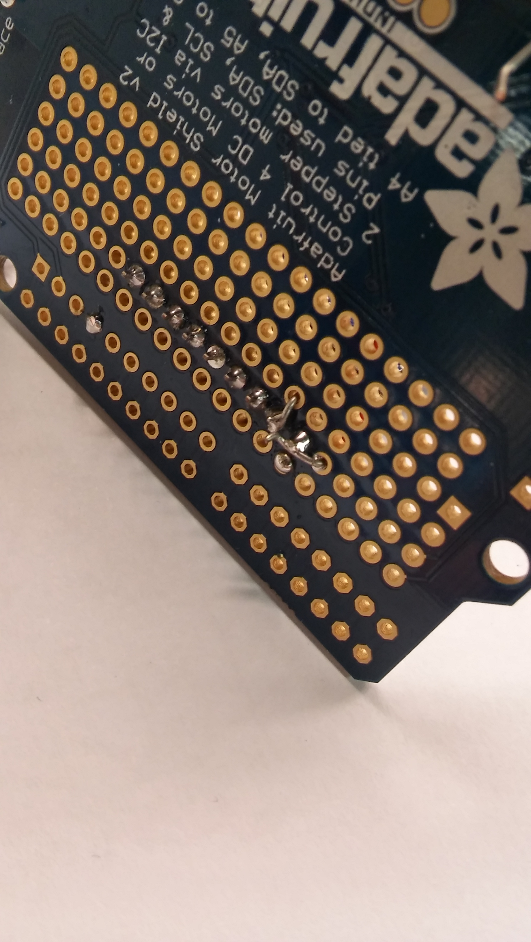
images/bluefruit/99.jpg
