michaelshiloh/motorShieldAndBluefruit/images/bluefruit/100.jpg

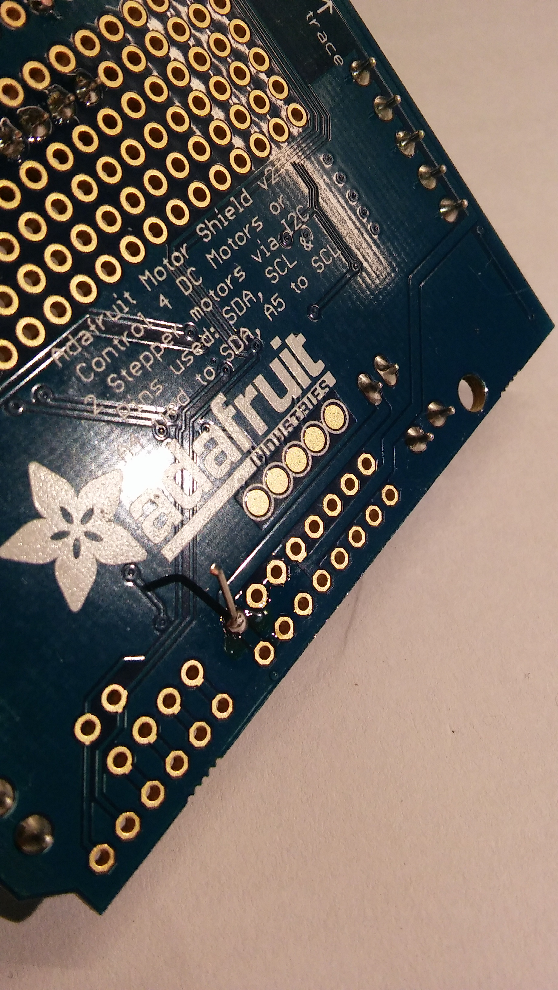
images/bluefruit/100.jpg
