michaelshiloh/motorShieldAndBluefruit/images/bluefruit/101.jpg

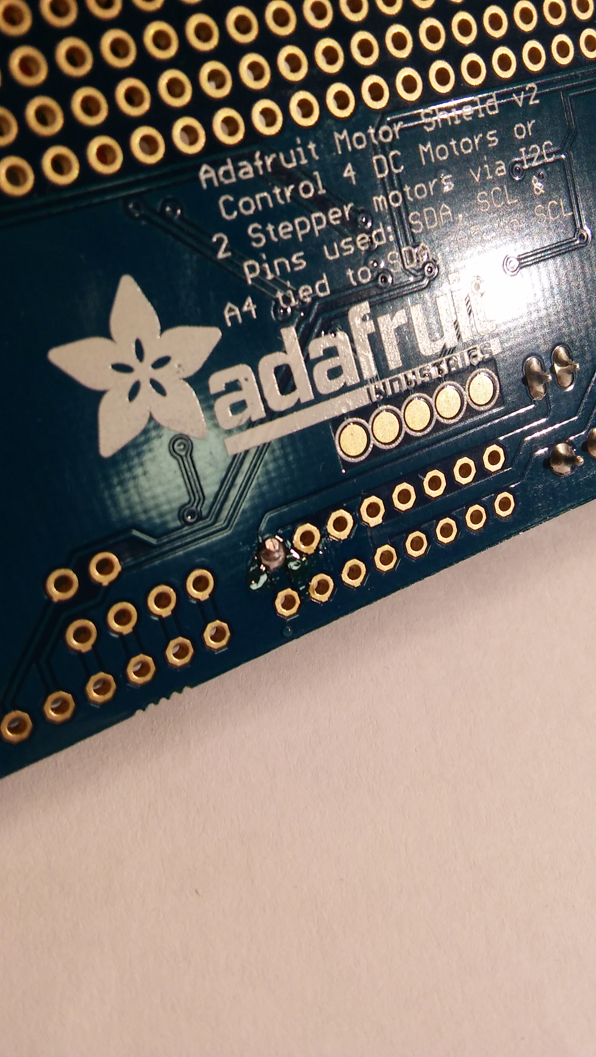
images/bluefruit/101.jpg
