michaelshiloh/motorShieldAndBluefruit/images/bluefruit/102.jpg

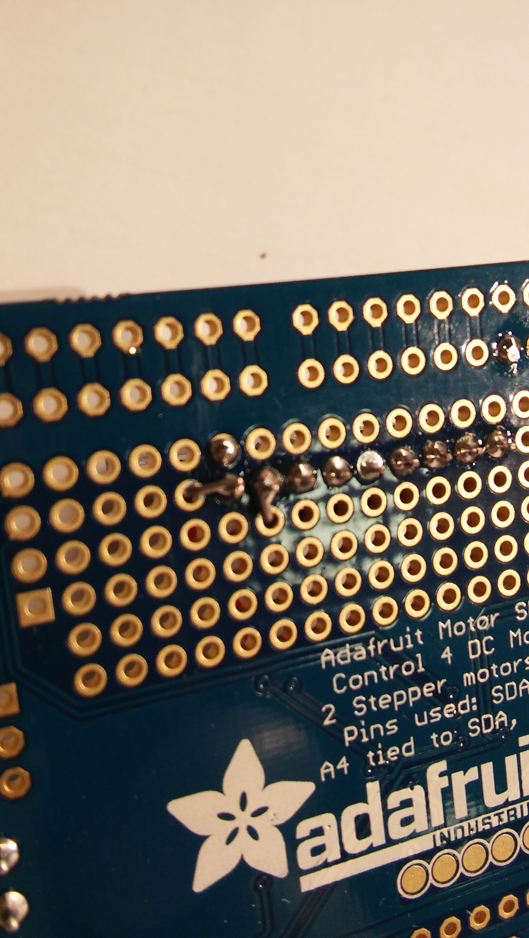
images/bluefruit/102.jpg
