michaelshiloh/motorShieldAndBluefruit/images/bluefruit/103.jpg

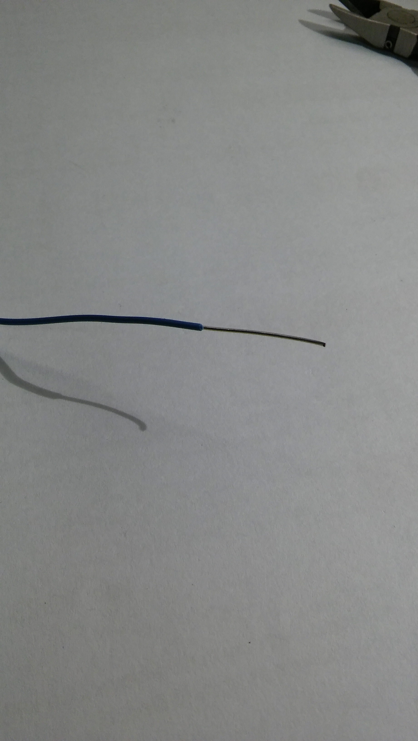
images/bluefruit/103.jpg
