michaelshiloh/motorShieldAndBluefruit/images/bluefruit/104.jpg

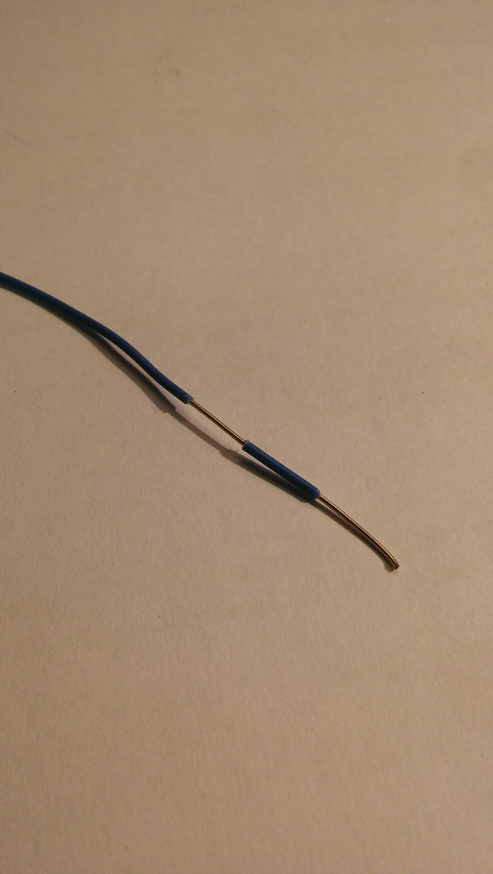
images/bluefruit/104.jpg
