michaelshiloh/motorShieldAndBluefruit/images/bluefruit/105.jpg

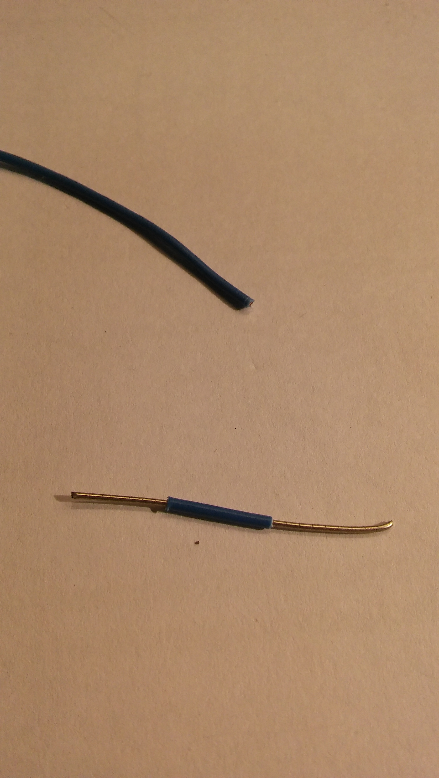
images/bluefruit/105.jpg
