michaelshiloh/motorShieldAndBluefruit/images/bluefruit/106.jpg

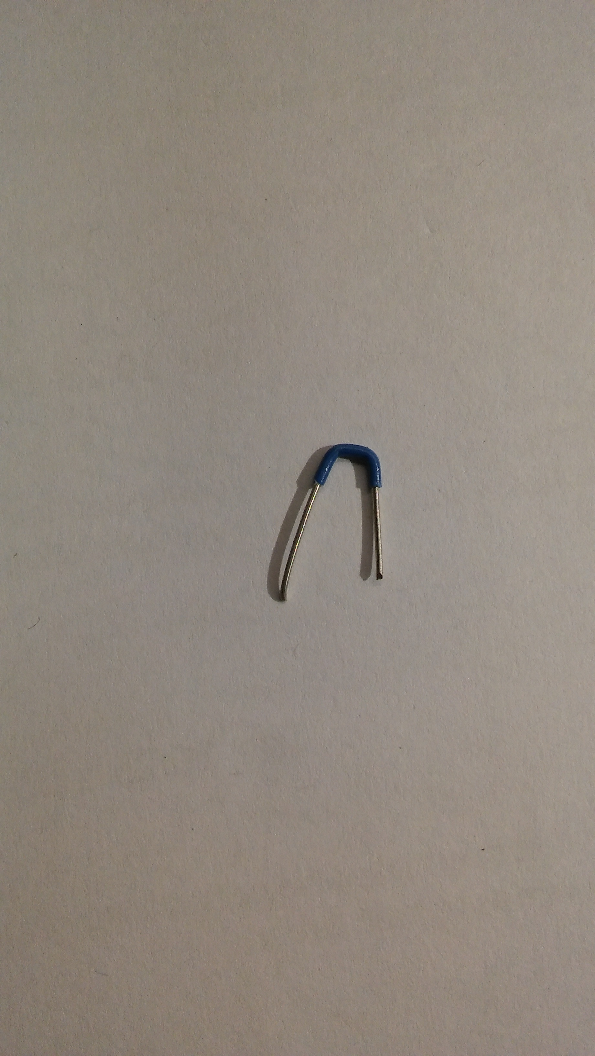
images/bluefruit/106.jpg
