michaelshiloh/motorShieldAndBluefruit/images/bluefruit/107.jpg

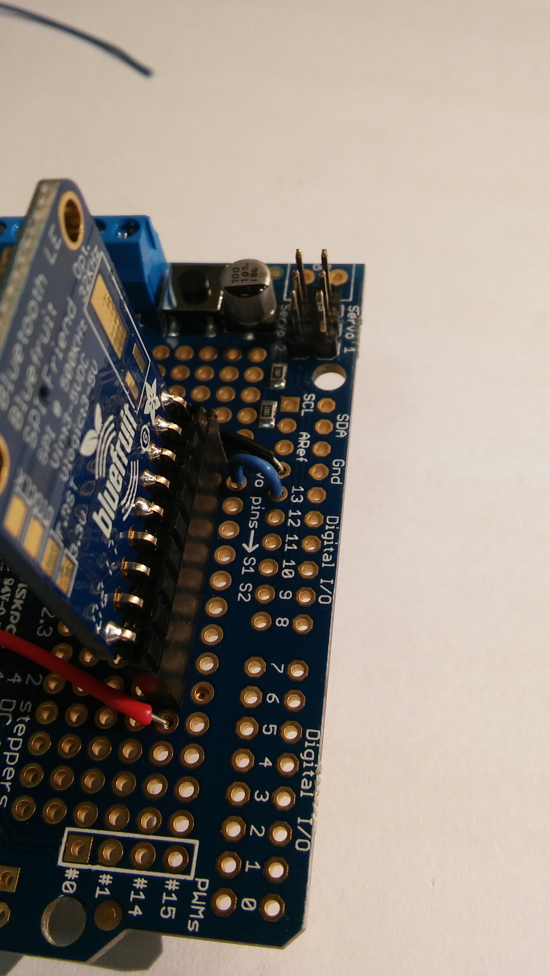
images/bluefruit/107.jpg
