michaelshiloh/motorShieldAndBluefruit/images/bluefruit/108.jpg

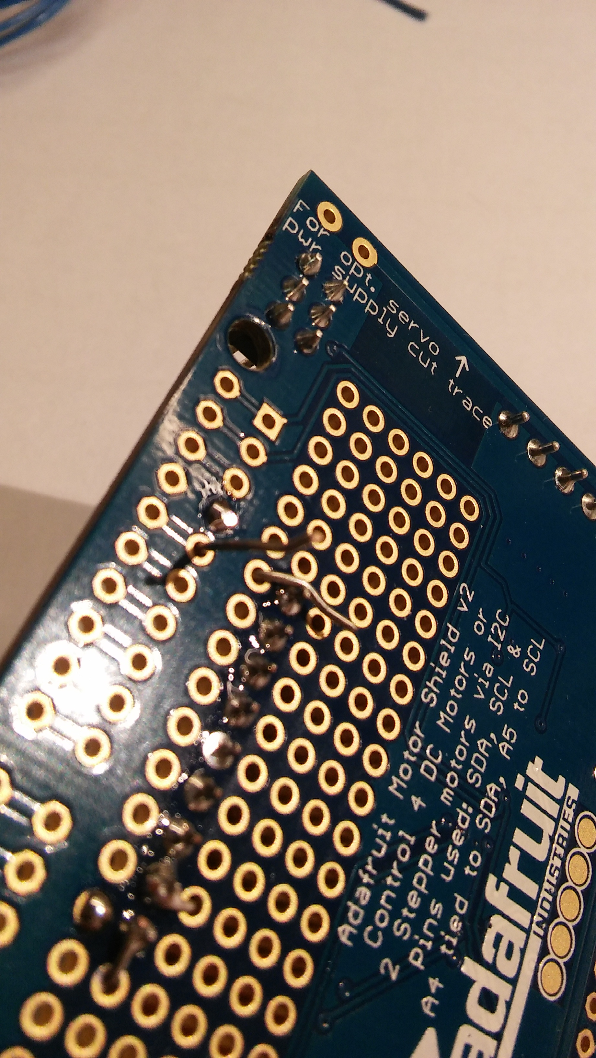
images/bluefruit/108.jpg
