michaelshiloh/motorShieldAndBluefruit/images/bluefruit/109.jpg

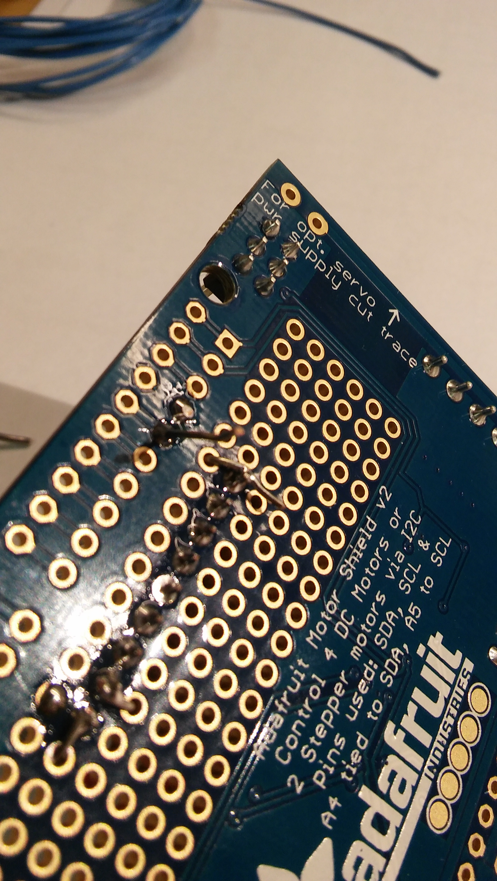
images/bluefruit/109.jpg
