michaelshiloh/motorShieldAndBluefruit/images/bluefruit/110.jpg

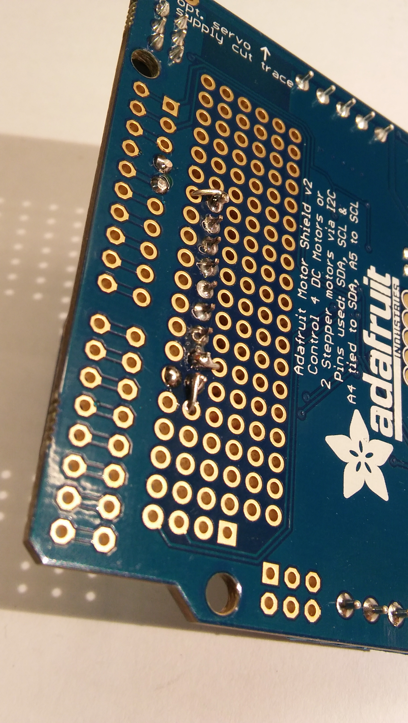
images/bluefruit/110.jpg
