michaelshiloh/motorShieldAndBluefruit/images/bluefruit/111.jpg

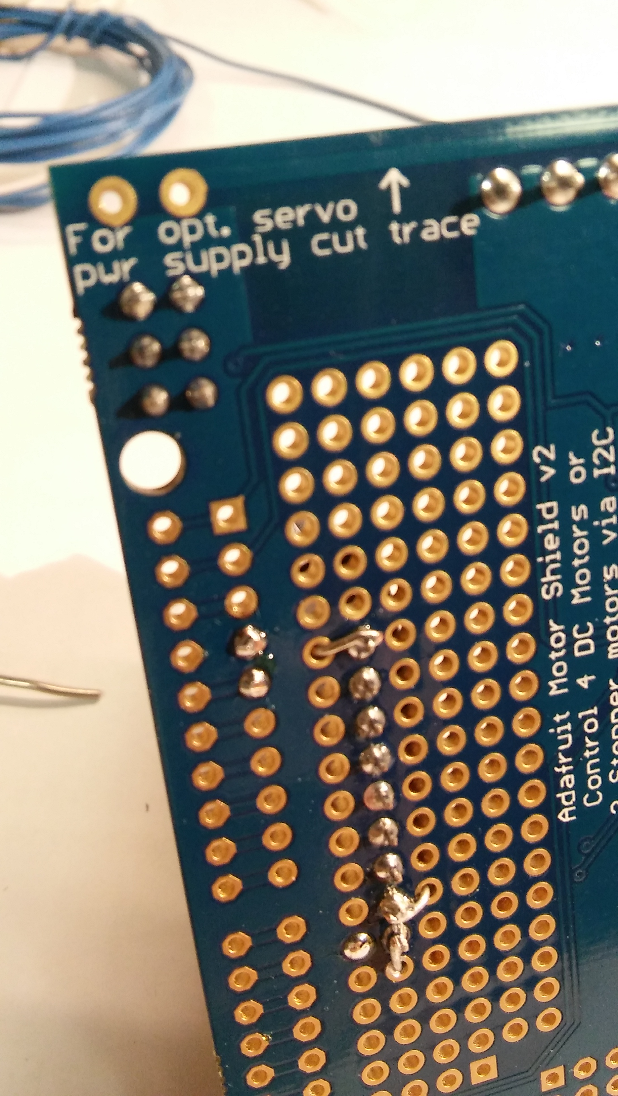
images/bluefruit/111.jpg
