michaelshiloh/motorShieldAndBluefruit/images/bluefruit/112.jpg

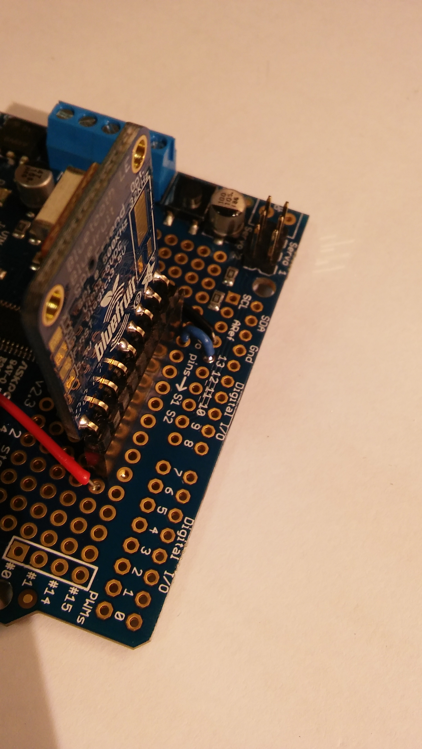
images/bluefruit/112.jpg
