michaelshiloh/motorShieldAndBluefruit/images/bluefruit/113.jpg

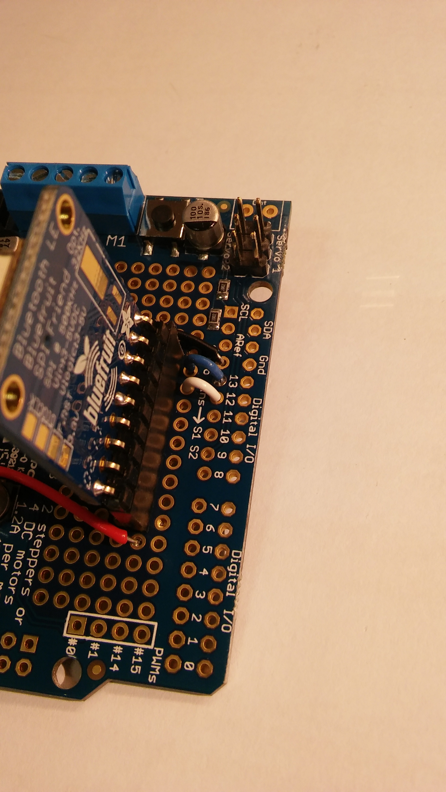
images/bluefruit/113.jpg
