michaelshiloh/motorShieldAndBluefruit/images/bluefruit/114.jpg

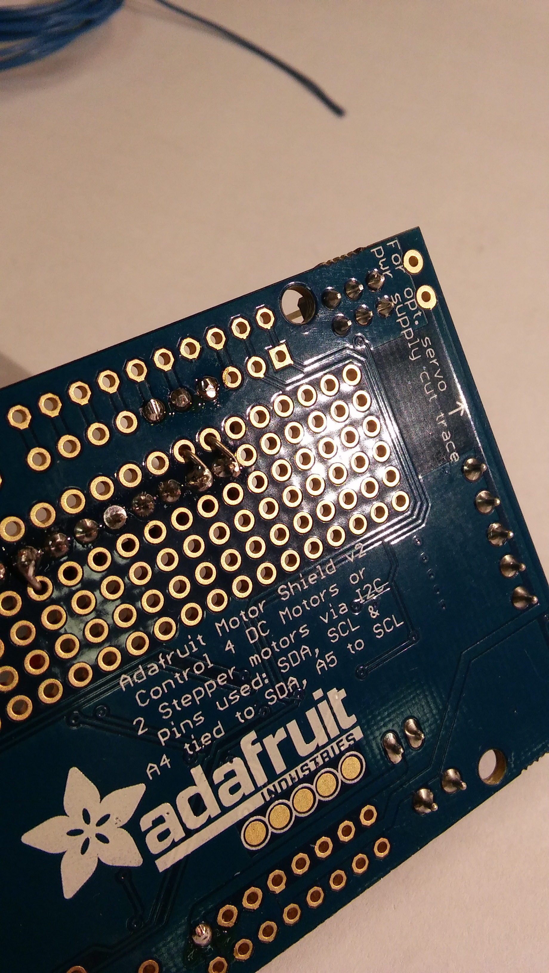
images/bluefruit/114.jpg
