michaelshiloh/motorShieldAndBluefruit/images/bluefruit/115.jpg

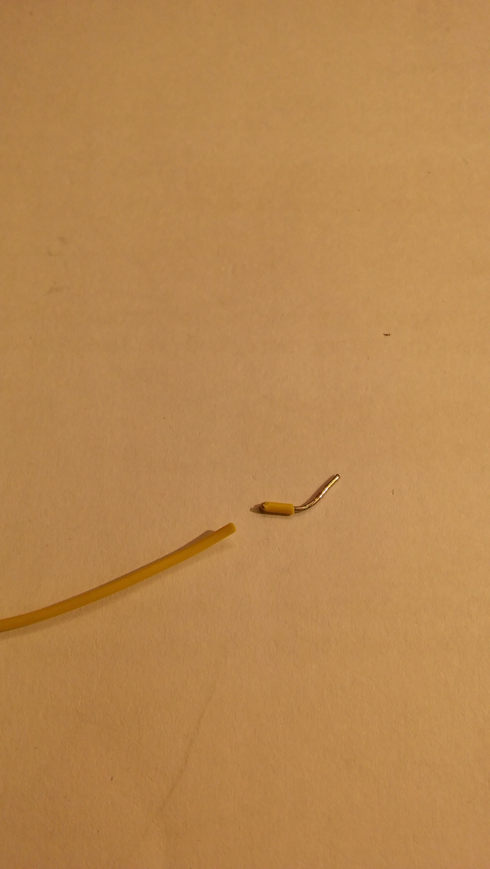
images/bluefruit/115.jpg
