michaelshiloh/motorShieldAndBluefruit/images/bluefruit/116.jpg

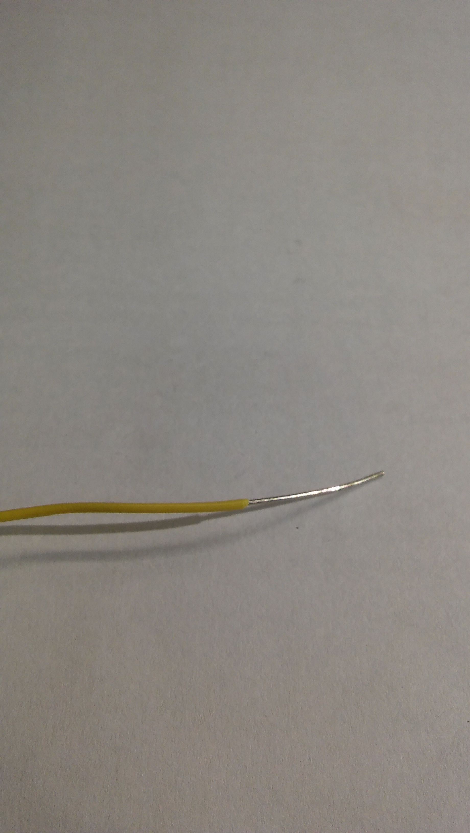
images/bluefruit/116.jpg
