michaelshiloh/motorShieldAndBluefruit/images/bluefruit/117.jpg

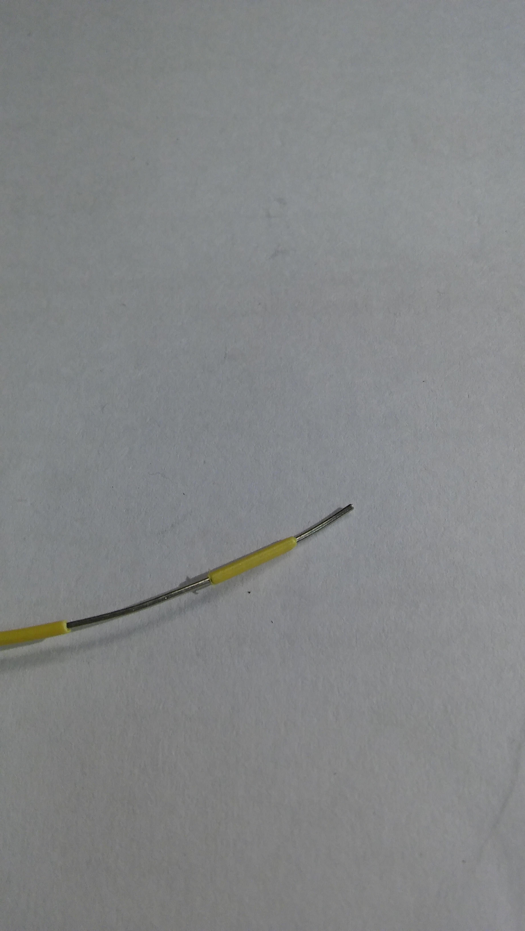
images/bluefruit/117.jpg
