michaelshiloh/motorShieldAndBluefruit/images/bluefruit/118.jpg

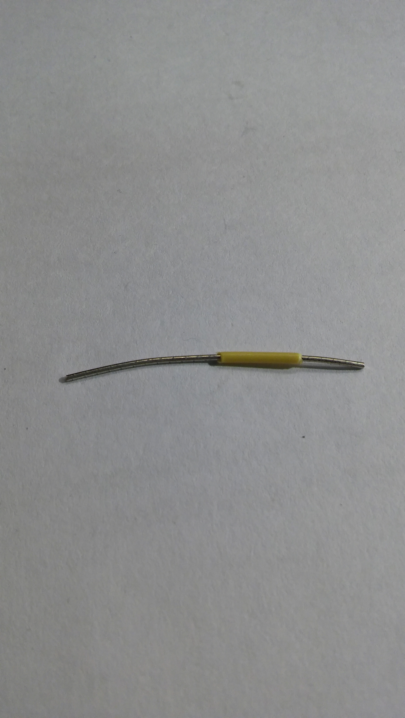
images/bluefruit/118.jpg
