michaelshiloh/motorShieldAndBluefruit/images/bluefruit/119.jpg

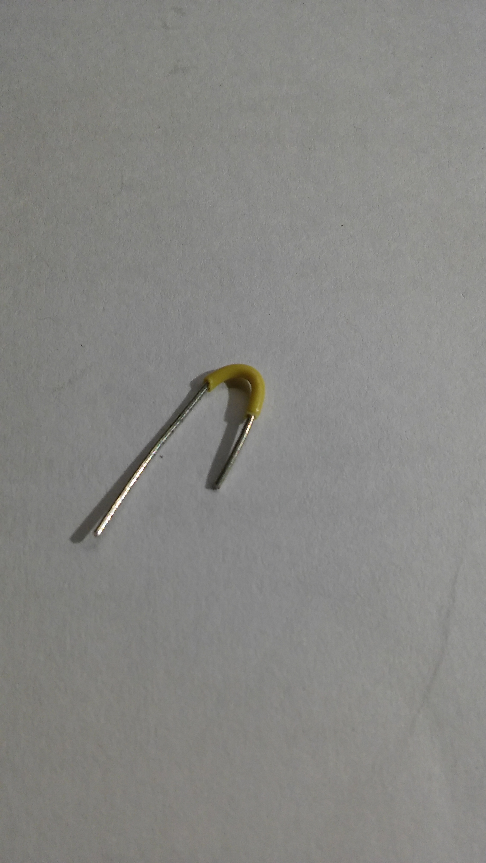
images/bluefruit/119.jpg
