michaelshiloh/motorShieldAndBluefruit/images/bluefruit/122.jpg

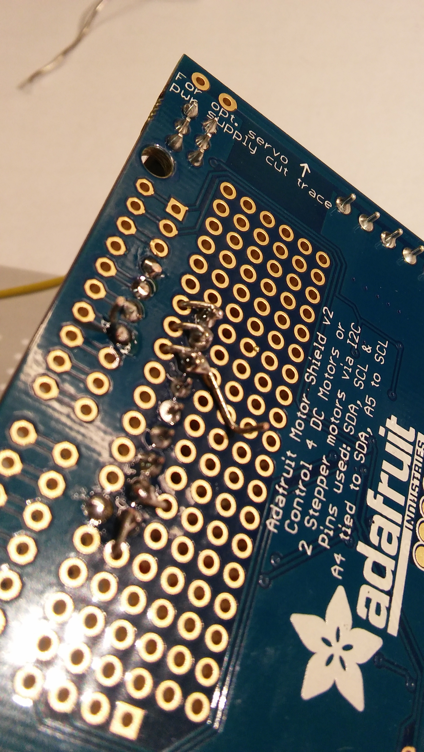
images/bluefruit/122.jpg
