michaelshiloh/motorShieldAndBluefruit/images/bluefruit/123.jpg

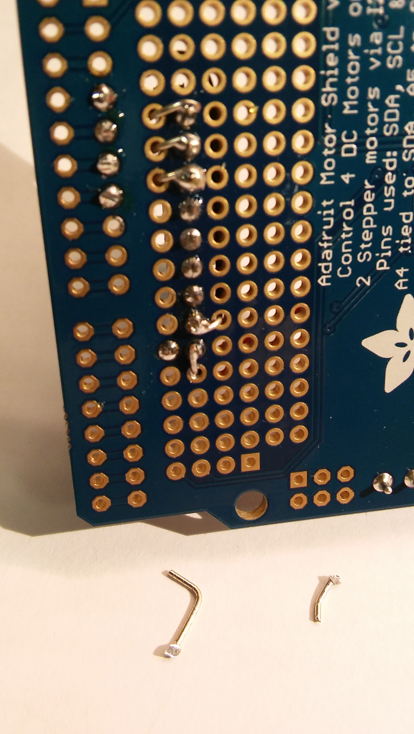
images/bluefruit/123.jpg
