michaelshiloh/motorShieldAndBluefruit/images/bluefruit/125.jpg

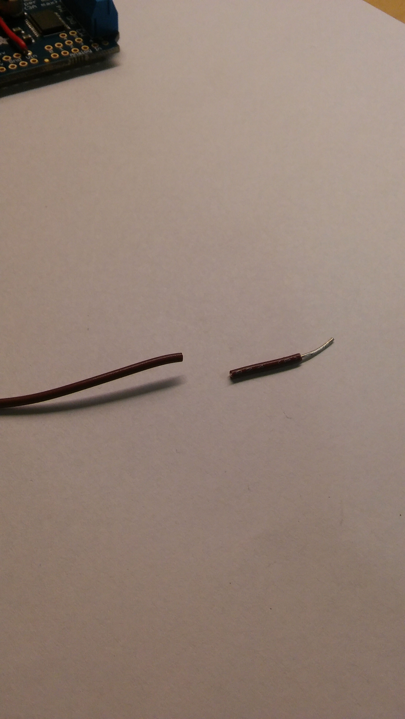
images/bluefruit/125.jpg
