michaelshiloh/motorShieldAndBluefruit/images/bluefruit/126.jpg

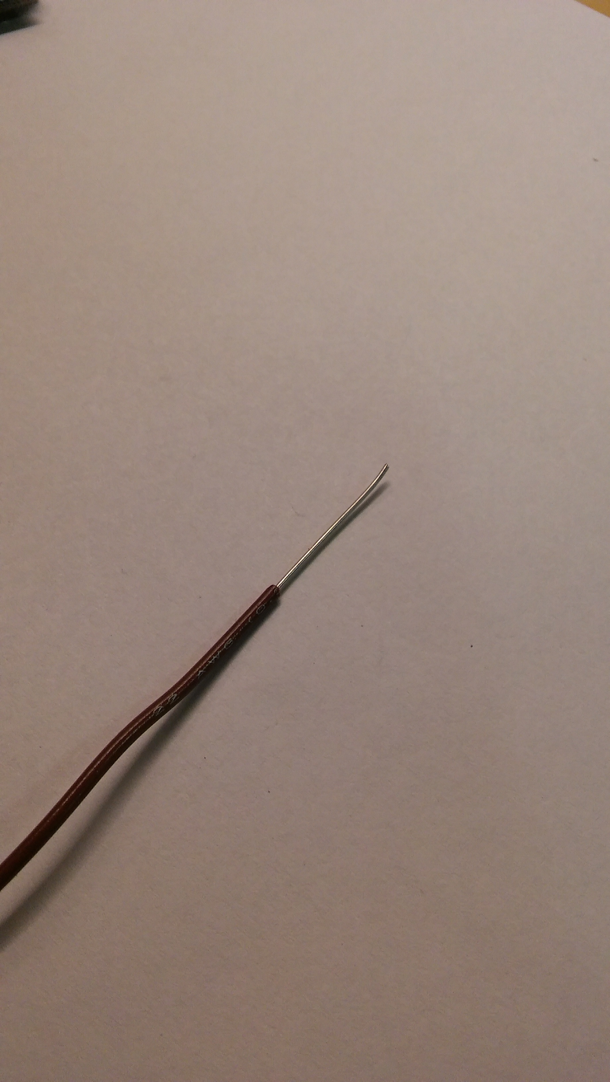
images/bluefruit/126.jpg
