michaelshiloh/motorShieldAndBluefruit/images/bluefruit/127.jpg

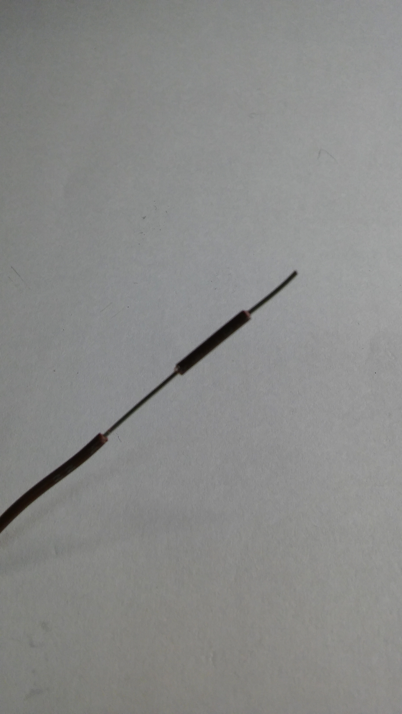
images/bluefruit/127.jpg
