michaelshiloh/motorShieldAndBluefruit/images/bluefruit/128.jpg

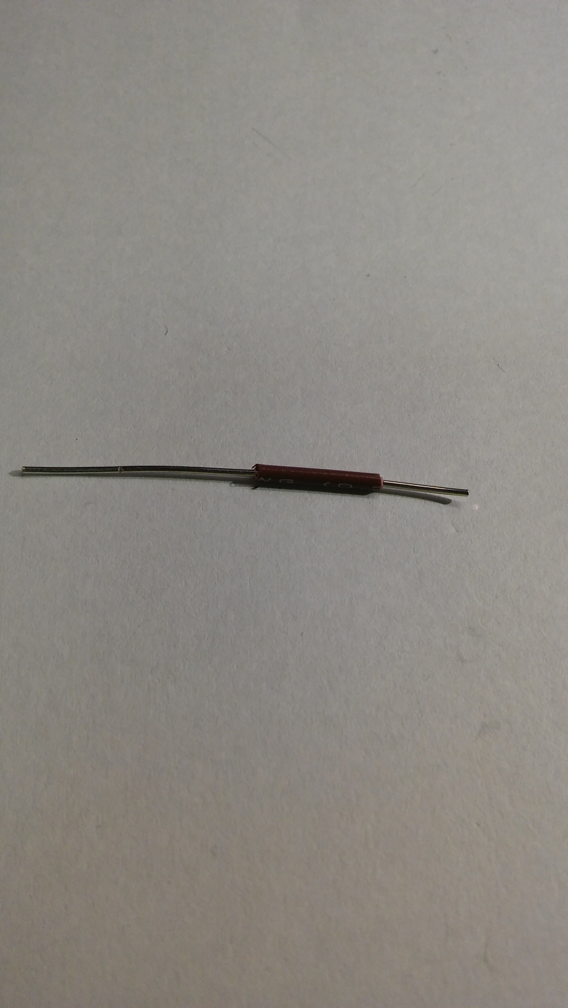
images/bluefruit/128.jpg
