michaelshiloh/motorShieldAndBluefruit/images/bluefruit/130.jpg

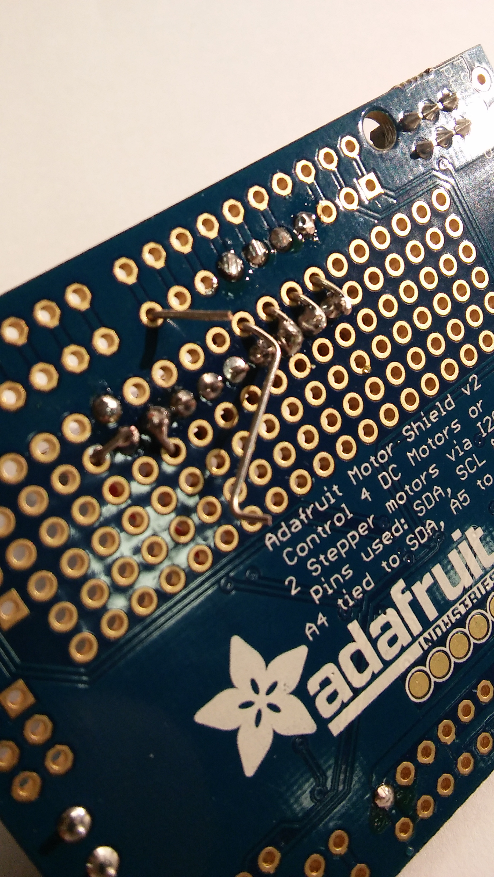
images/bluefruit/130.jpg
