michaelshiloh/motorShieldAndBluefruit/images/bluefruit/131.jpg

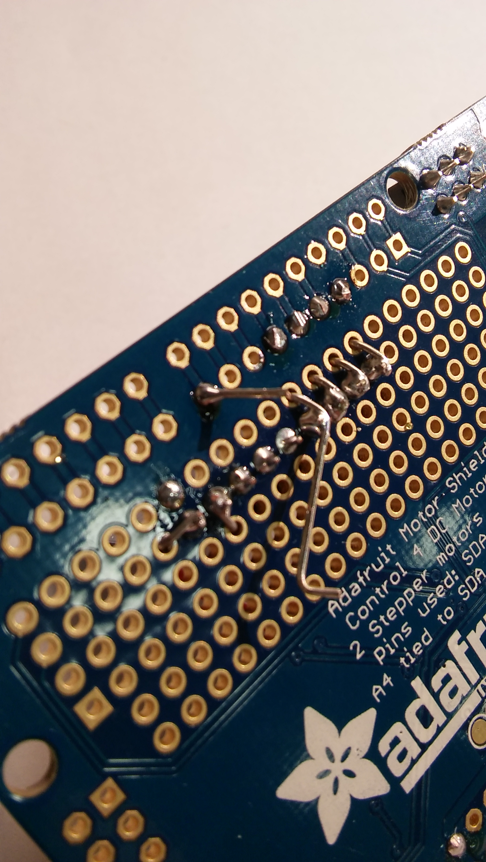
images/bluefruit/131.jpg
