michaelshiloh/motorShieldAndBluefruit/images/bluefruit/133.jpg

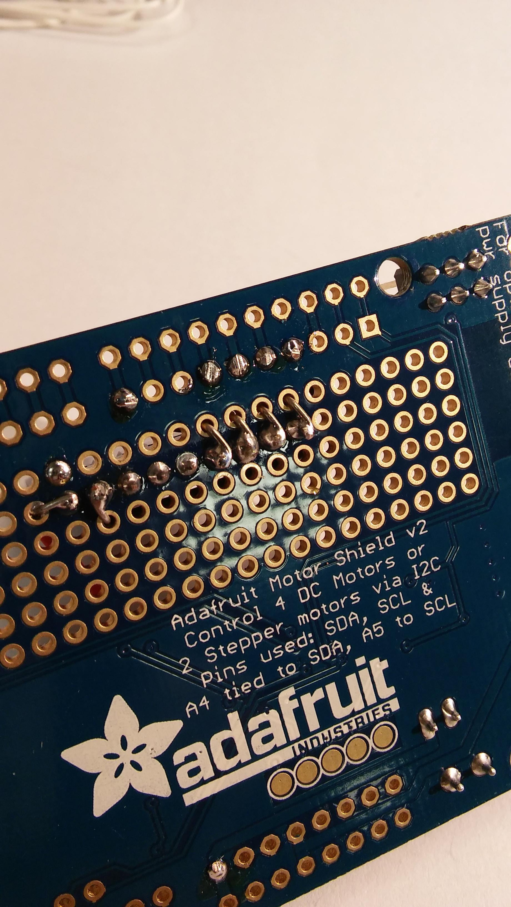
images/bluefruit/133.jpg
