michaelshiloh/motorShieldAndBluefruit/images/bluefruit/134.jpg

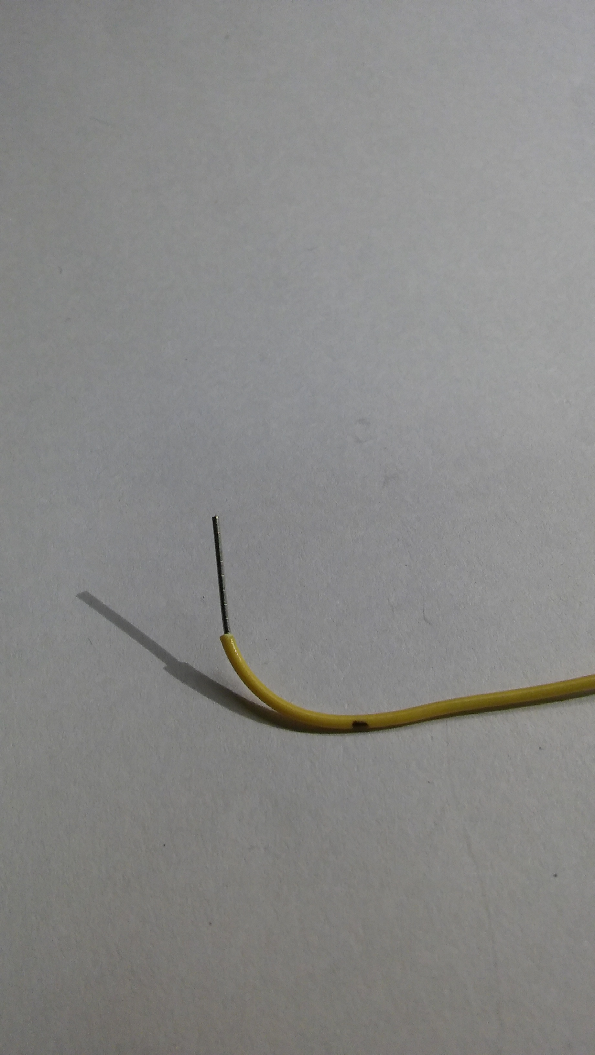
images/bluefruit/134.jpg
