michaelshiloh/motorShieldAndBluefruit/images/bluefruit/135.jpg

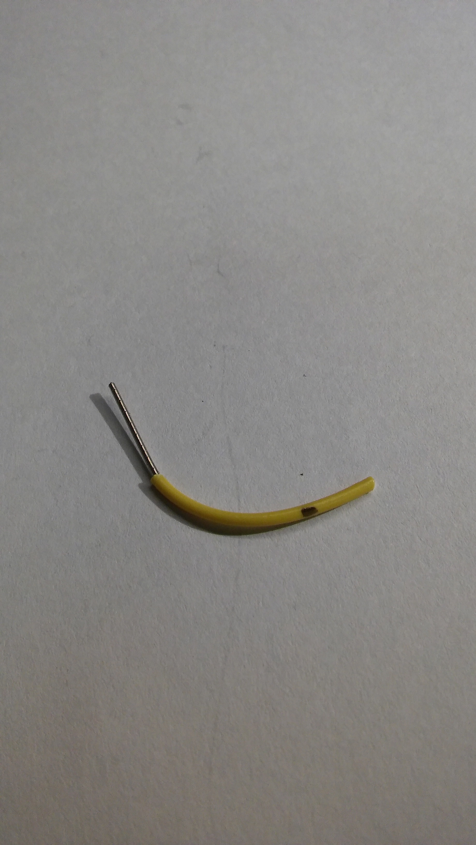
images/bluefruit/135.jpg
