michaelshiloh/motorShieldAndBluefruit/images/bluefruit/136.jpg

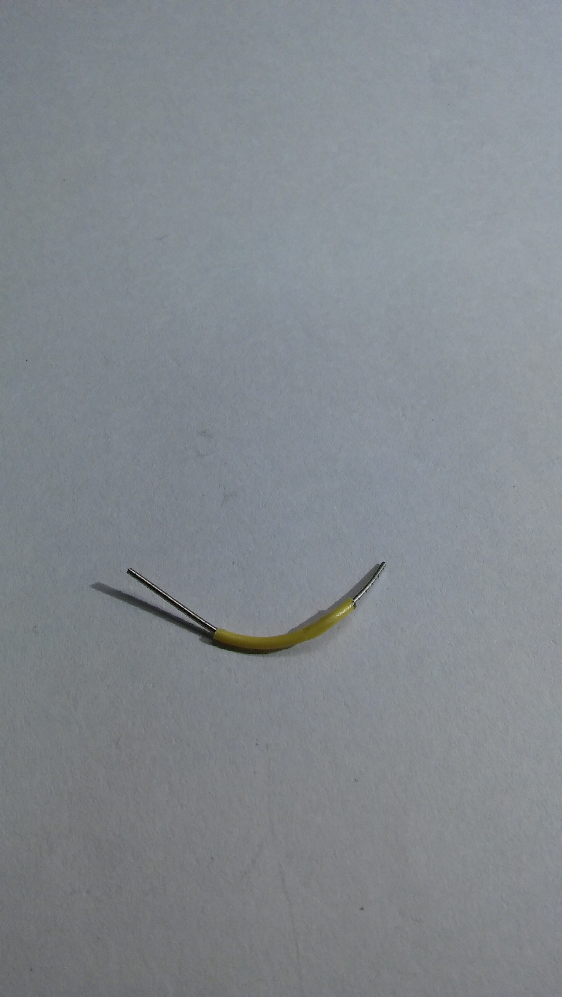
images/bluefruit/136.jpg
