michaelshiloh/motorShieldAndBluefruit/images/bluefruit/137.jpg

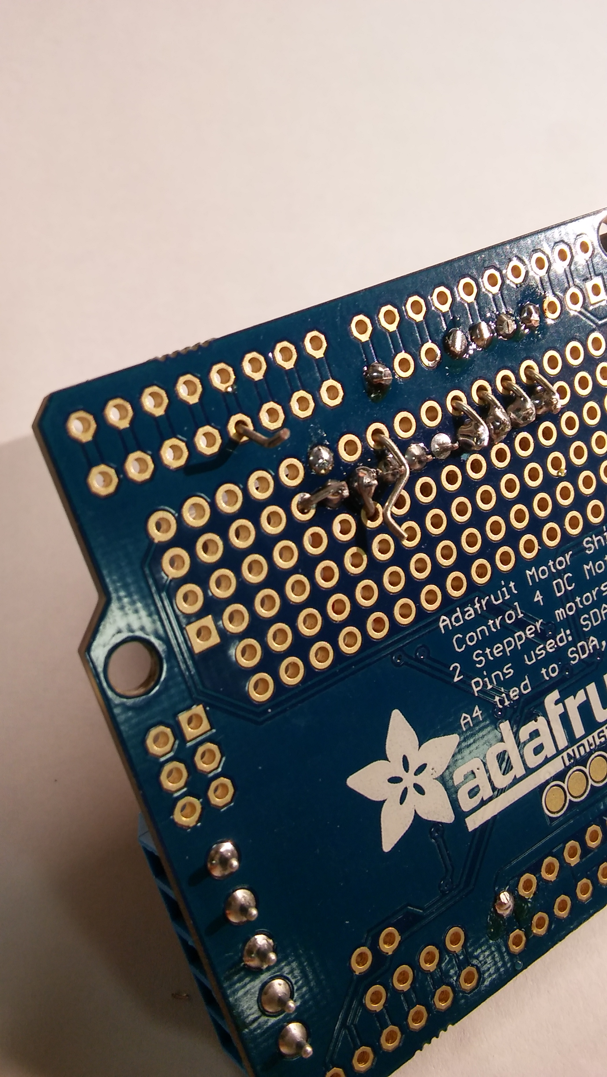
images/bluefruit/137.jpg
