michaelshiloh/motorShieldAndBluefruit/images/bluefruit/139.jpg

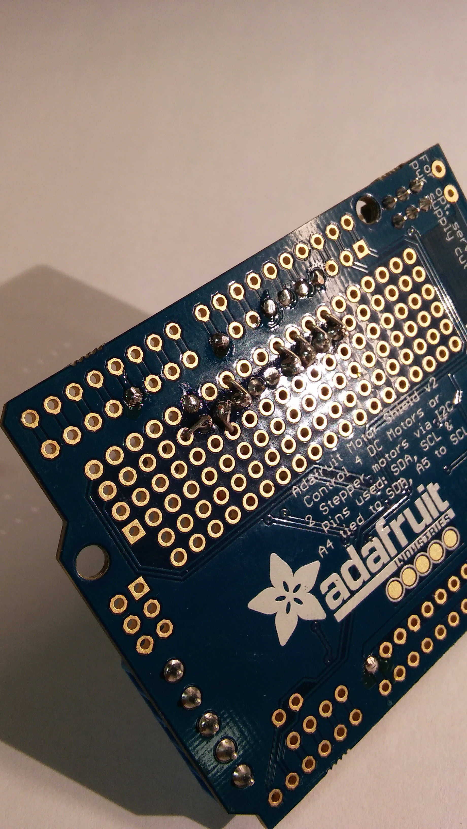
images/bluefruit/139.jpg
