michaelshiloh/motorShieldAndBluefruit/images/bluefruit/143.jpg

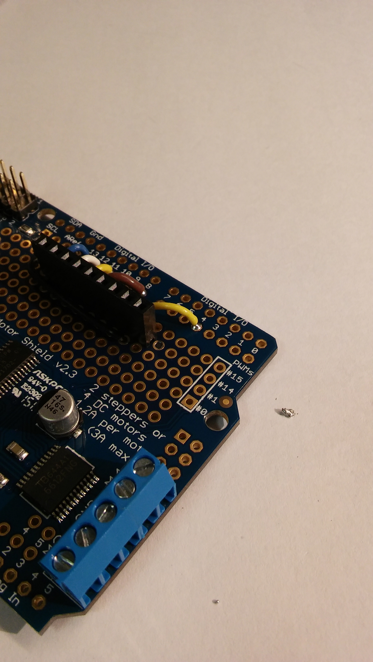
images/bluefruit/143.jpg
