michaelshiloh/motorShieldAndBluefruit/images/bluefruit/144.jpg

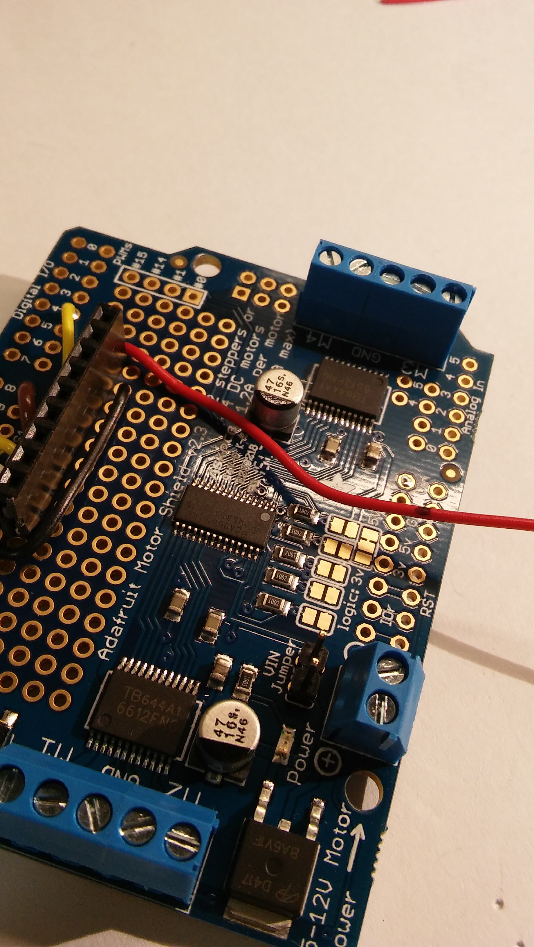
images/bluefruit/144.jpg
