michaelshiloh/motorShieldAndBluefruit/images/bluefruit/145.jpg

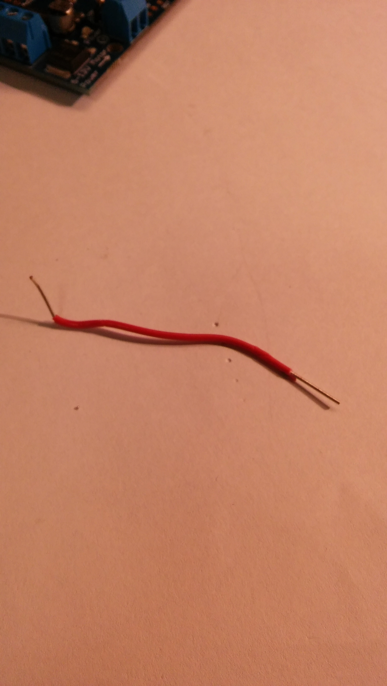
images/bluefruit/145.jpg
