michaelshiloh/motorShieldAndBluefruit/images/bluefruit/146.jpg

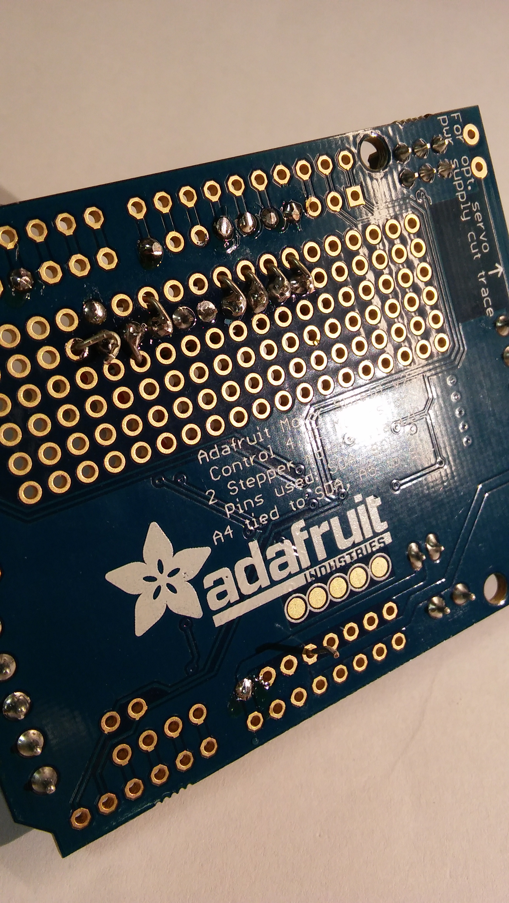
images/bluefruit/146.jpg
