michaelshiloh/motorShieldAndBluefruit/images/bluefruit/147.jpg

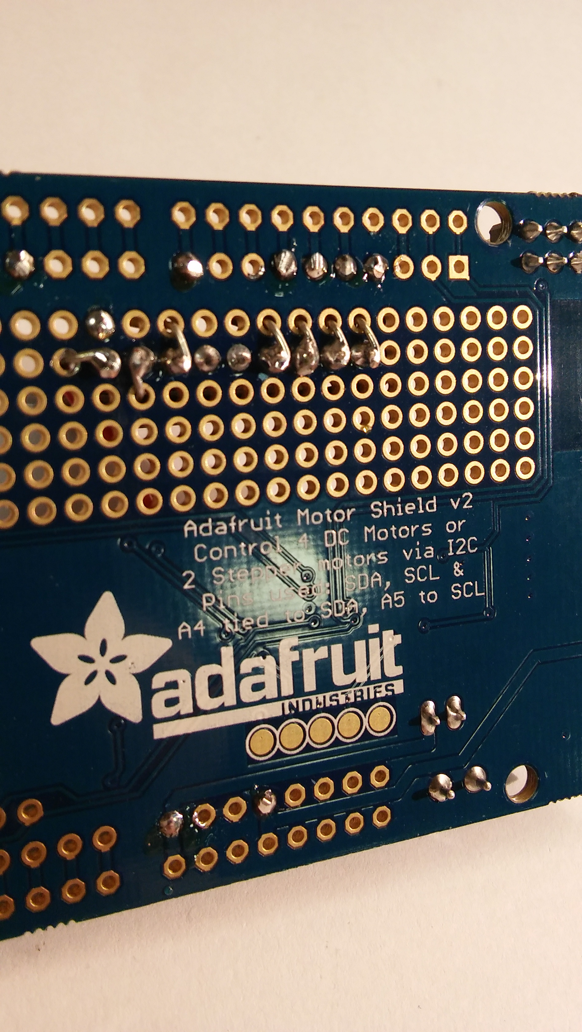
images/bluefruit/147.jpg
