michaelshiloh/motorShieldAndBluefruit/images/bluefruit/149.jpg

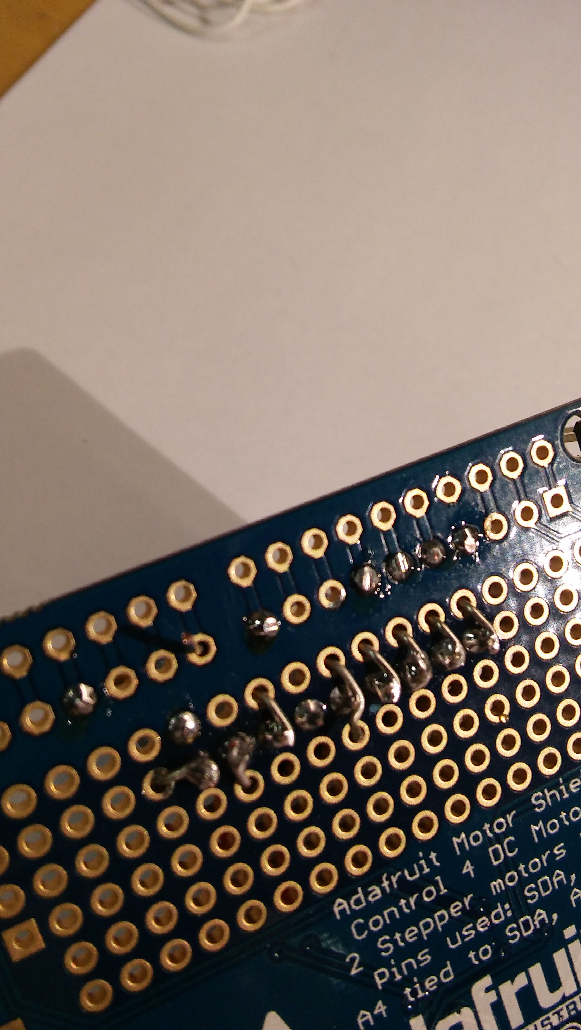
images/bluefruit/149.jpg
