michaelshiloh/motorShieldAndBluefruit/images/bluefruit/151.jpg

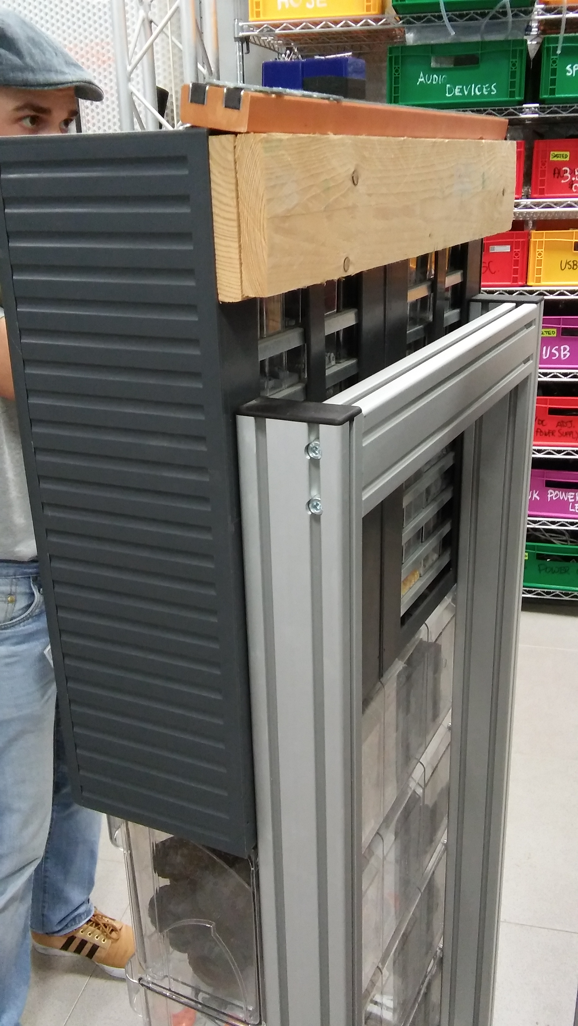
images/bluefruit/151.jpg
