michaelshiloh/motorShieldAndBluefruit/images/bluefruit/152.jpg

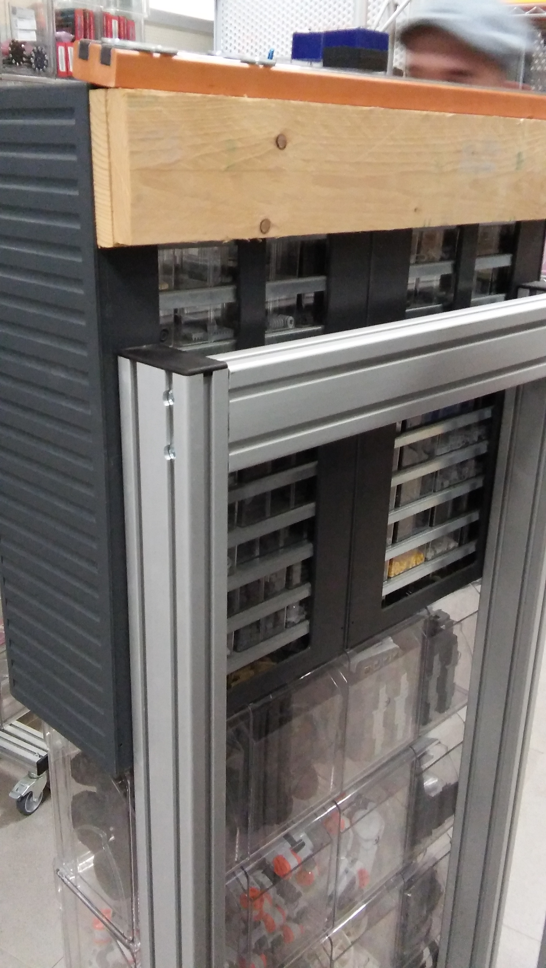
images/bluefruit/152.jpg
