michaelshiloh/motorShieldAndBluefruit/images/bluefruit/153.jpg

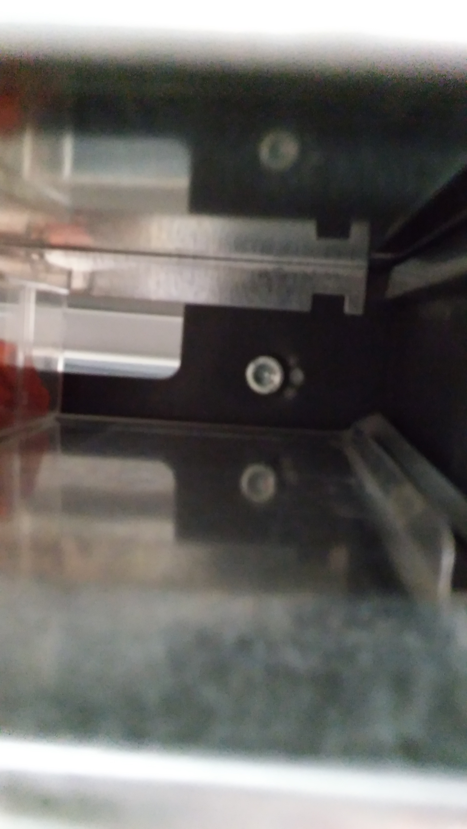
images/bluefruit/153.jpg
