michaelshiloh/motorShieldAndBluefruit/images/bluefruit/155.jpg

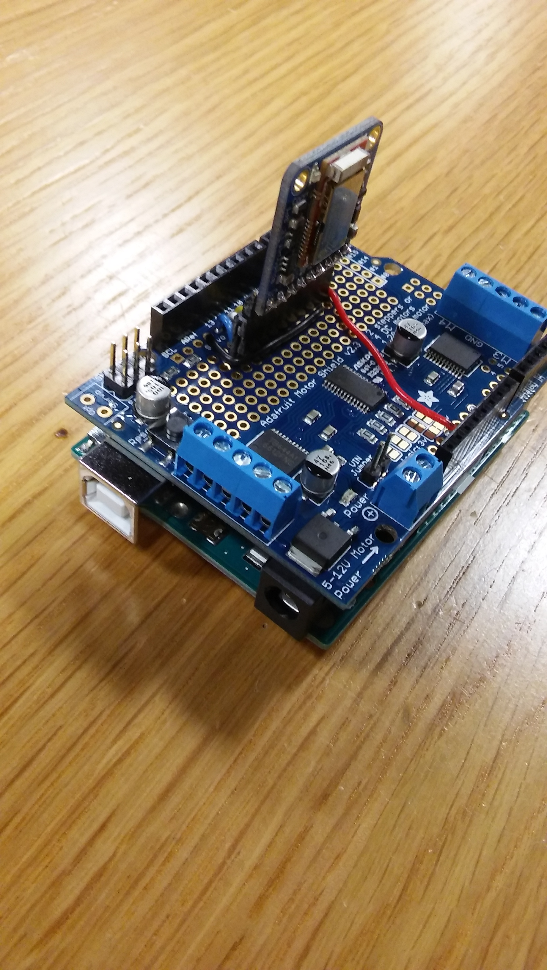
images/bluefruit/155.jpg
