michaelshiloh/motorShieldAndBluefruit/images/bluefruit/156.jpg

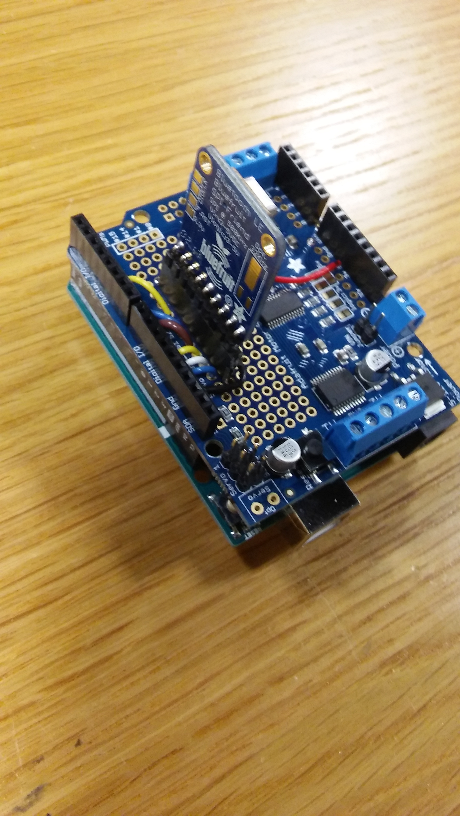
images/bluefruit/156.jpg
