michaelshiloh/motorShieldAndBluefruit/images/bluefruit/157.jpg

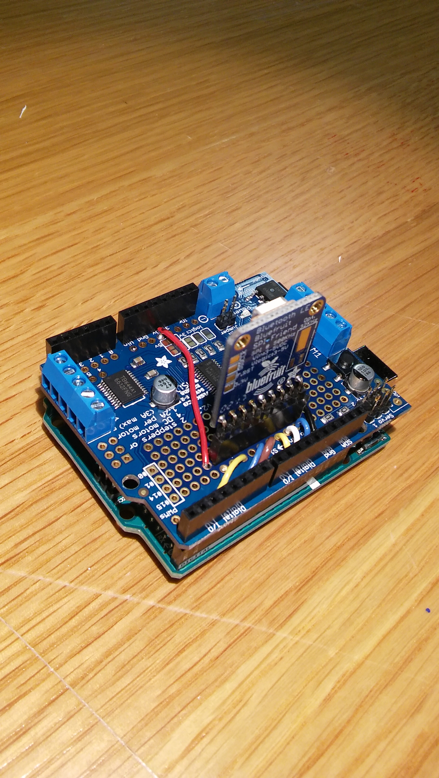
images/bluefruit/157.jpg
