michaelshiloh/motorShieldAndBluefruit/images/cutTraceToUseOptionalServoInput.jpg

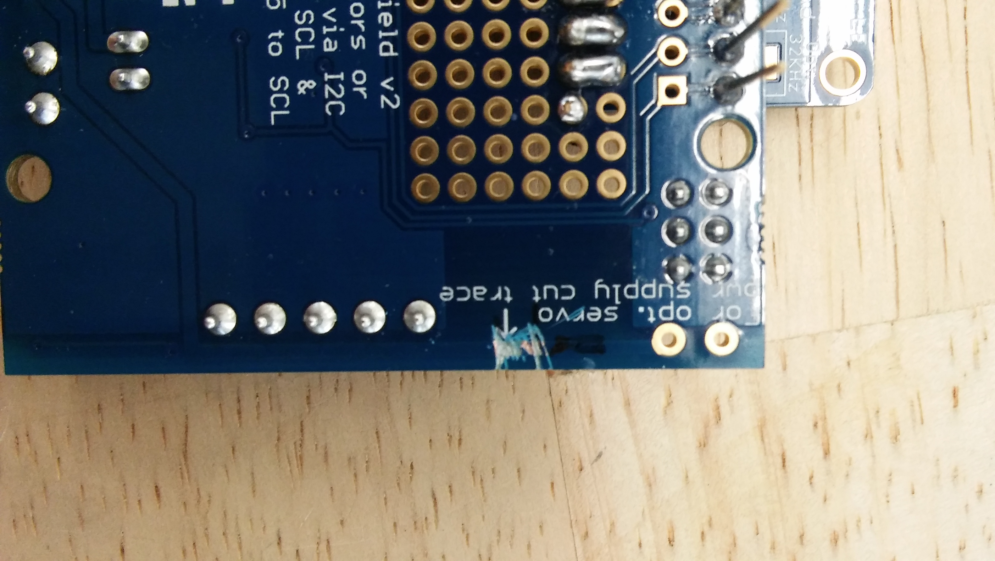
images/cutTraceToUseOptionalServoInput.jpg
