michaelshiloh/motorShieldAndBluefruit/images/motorShieldOptServo_bb.png

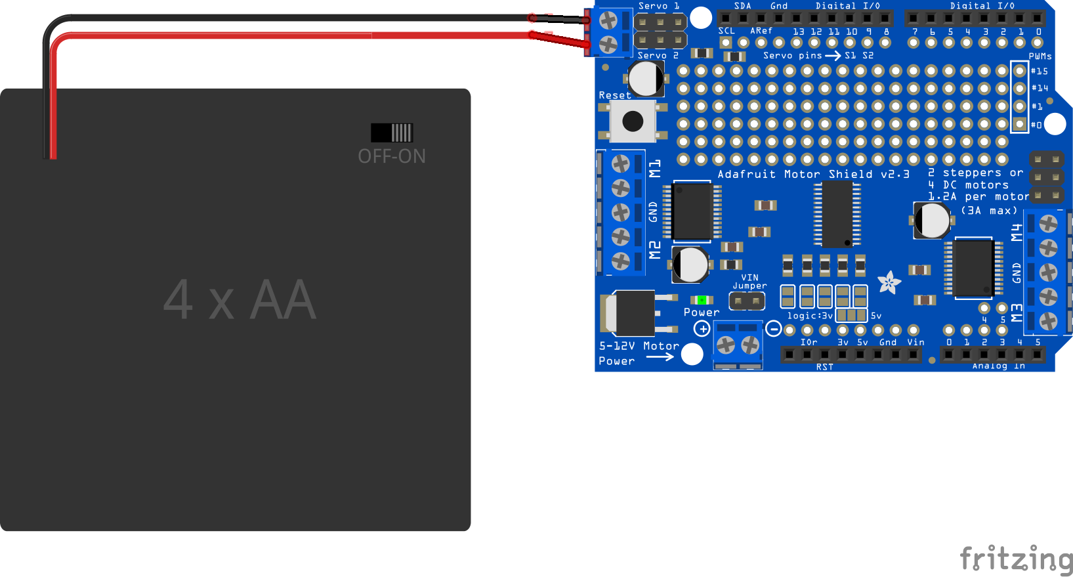
images/motorShieldOptServo_bb.png
