michaelshiloh/motorShieldAndBluefruit/images/optionalServoPowerInput.jpg

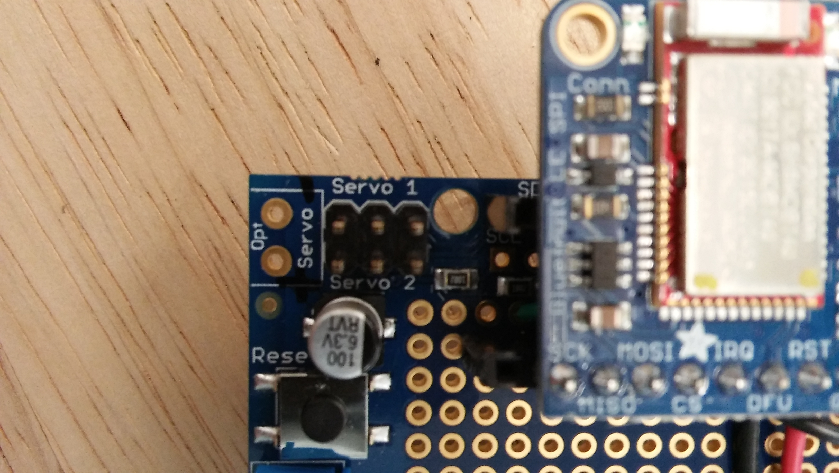
images/optionalServoPowerInput.jpg
