michaelshiloh/motorShieldAndBluefruit/(commit log)

2017-06-21 how to add opt servo
2017-09-08 added instructions for installing motor shield library
